janspale/DEXPAND/performance_mapping/Dexpand_Design_study_apw100624.xlsx

Sheet: MM-Elektra assessment
MM Elektra design Study
Medium: | mm
Einheiten: | SI | SI with C
 |  | Power |  | 4 | kW
 |  | Inlet pressure |  | 6.5 | bar | inlet enthalpy | 340.8054099 | kJ/kg
 |  | Inlet Temperature |  | 190 | °C | inlet entropy | 0.787455107 | kj/kg/K
 |  | outlet pressure |  | 0.55 | bar | outlet enthalpy | 289.3110147 | kJ/kg
 |  | enthalpy drop, isentropic |  | 51494.4 | J/kg |  | 3000 | rpm
 |  | spouting velocity |  | 320.9 | m/s
 |  | expansion efficiency |  | 0.4
 |  | massenstrom |  | 0.194 | kg/s
 |  | Power | remark | estimated efficiency | mass flow rate | wheel passes | u_opt | D | h | # nozzles | #flows | mass flow ratio | area ratio
 |  | kW |  |  |  |  | m/s | m | m | -
 | Reference | 4 | experimentally determined | 0.4 | 0.1942 | 4 | 40.11 | 0.2554 | 0.0200 | 2 | 1 | 1.00 | 1.00
 |  | 1 | assessment, smaller than | 0.3 | 0.0647 | 4 | 40.11 | 0.2554 | 0.0130 | 1 | 1 | 0.33 | 0.32
 |  | 2 | experimentally determined | 0.4 | 0.0971 | 4 | 40.11 | 0.2554 | 0.0200 | 1 | 1 | 0.50 | 0.50
 |  | 8 | experimentally determined, better than | 0.4 | 0.3884 | 4 | 40.11 | 0.2554 | 0.0400 | 2 | 1 | 2.00 | 2.00
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
