janspale/DEXPAND/design_tools/RVE_small_Scale.xlsm

Sheet: Hlavní
Nastavení výpočtu (odhad výpočetního času: 24 sekund) |  |  |  | Vstupní parametry cyklu |  |  |  | Zjednodušený model expandér + výparník
Počet kroků | j | - | 1440 | Pracovní látka | PL | - | R1233zdE | Hypotetická průtočná plocha exp | S_exp | mm2 | 12.0
Počet iterací |  | - | 2 | Kritický tlakový poměr | beta_krit | - | 0.61 | Průtok průtočnou plochou S_exp | M_hyp | kg/s | #NAME?
Čas kroku | time | s | 1.375137514e-05 | Tepelný výkon výměníků | Q_vym | kW | 10 | dm = 0, měň S (krok 1) | dif_m1 | mg/s
Hlavní parametry - stroj |  |  |  | Podíl oleje | podil_olej | - | 0.05 | dm = 0, měň t_ad (krok 2) | dif_m2 | mg/s | #NAME?
Průměr statoru | D | #VALUE! | 64.0 | Tepelná kapacita oleje | cp_olej | kJ/kg | 2.2 | reziduum tepelného výkonu | q_rez | kW | 3.745
Průměr rotoru | d | #VALUE! | 55.0 | Admisní teplota | t_ad | °C | 105.0 | Výstupní parametry - geometrie
Radiální vůle | vr | mm | 0.1 | Admisní přehřátí | dT_ad | K | 5 | Vstupní objem | V_init | mm3 | 2698.901387
Excentricita, Dop.: (3.5 až 4.5) | e | mm | 4.4 | Admisní tlak | p_ad | kPa | 1042.3 | Výstupní objem | V_out | mm3 | 6819.902706
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
