janspale/DEXPAND/design_tools/orc_axial/orcturbax_v8_r10.xlsm

Sheet: main
 |  |  |  |  |  |  | 122.0987534 |  |  |  |  |  |  |  | 432.159
 |  | MIDSPAN |  |  |  | 122.0987534 |  | 11.81818182 |  |  |  | 432.009
MM |  | Thermodynamic BCs |  |  | Turbomachine BCs |  |  | Calculation of output parameters |  |  | Critical temperature iteration |  |  | Calculation of the nozzle |  |  | Additional losses |  |  |  |  |  | 8.314446 |  |  |  |  |  |  | h_nozz | 11 | mm
tp |  | p_1 | 0.65 | Mpa | n | 16000 | rpm | a_2_is | 147.067371 | m/s | T*_id | 171.5243379 | °C | T_2 | 159.009 | °C | P_loss_dfr | 36.50324376 | W |  | 0.08461538462 |  | 162.38 |  |  | 12.751 |  |  |  |  | alpha_2 | eta_is | h_out/h_in
ph | 463.15 | T_1 | 190 | °C | D | 0.15 | m | Ma_2_is | 2.1821201 | - | T*_it | 181.4743379 | °C | T_2_is | 153.657 | °C | P_loss_venti | 912.9356393 | W |  |  |  | 0.05120363345 |  |  | 1.2 |  |  | 2.37354531 |  | 7 | 0.7081 | 1.28
ps |  | p_3 | 0.055 | MPa | alpha_2 | 14 | ° | phi_2 | 0.8986596721 |  | a*_it | 134.2638479 | m/s | p_2 | 0.055 | Mpa | P_turb | 9765.45 | W |  |  |  | 51.20363345 |  |  | 15.3012 |  |  |  |  | 8 | 0.6979 | 1.266
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
