janspale/DEXPAND/experimental_data/air_PDLT/RVE_air_PDLT_steady_states_designconditions.csv

pin | rotation speed | torque | Power | volumetric flow rate (DN 40) | p1 | p2 | p3 | p4 | p5 | p6 | room temp
bara | U/min | Nm | W | Nmｳ/h | bar | bar | bar | bar | bar | bar | ｰC
9.02 | 3280.858464 | -3.282088 | -1058.889499 | 48.872802 | 0.980102 | 0.977905 | 0.974324 | 0.979586 | 0.97899 | 0.979739 | 21.749303
9.02 | 3280.807994 | -3.279765 | -1058.12318 | 48.884788 | 0.980092 | 0.977902 | 0.974335 | 0.97958 | 0.978986 | 0.979739 | 21.749361
9.02 | 3278.78923 | -3.186844 | -1027.470422 | 49.364238 | 0.979665 | 0.977788 | 0.974799 | 0.979348 | 0.978831 | 0.979749 | 21.751672
9.02 | 3278.76039 | -3.187324 | -1027.615728 | 49.337389 | 0.97968 | 0.9778 | 0.974792 | 0.979355 | 0.978839 | 0.979751 | 21.750482
9.02 | 3278.19802 | -3.196697 | -1030.449188 | 48.813829 | 0.979981 | 0.978026 | 0.974659 | 0.979497 | 0.978999 | 0.979804 | 21.727273
9.02 | 3278.390283 | -3.19926 | -1031.340372 | 48.813829 | 0.979996 | 0.978009 | 0.974688 | 0.979498 | 0.978978 | 0.979816 | 21.731109
9.02 | 3280.168719 | -3.222971 | -1039.583829 | 48.813829 | 0.98013 | 0.977858 | 0.974957 | 0.979511 | 0.978785 | 0.979921 | 21.766595
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
