janspale/DEXPAND/design_tools/orc_axial/expansion_line_h_s.png

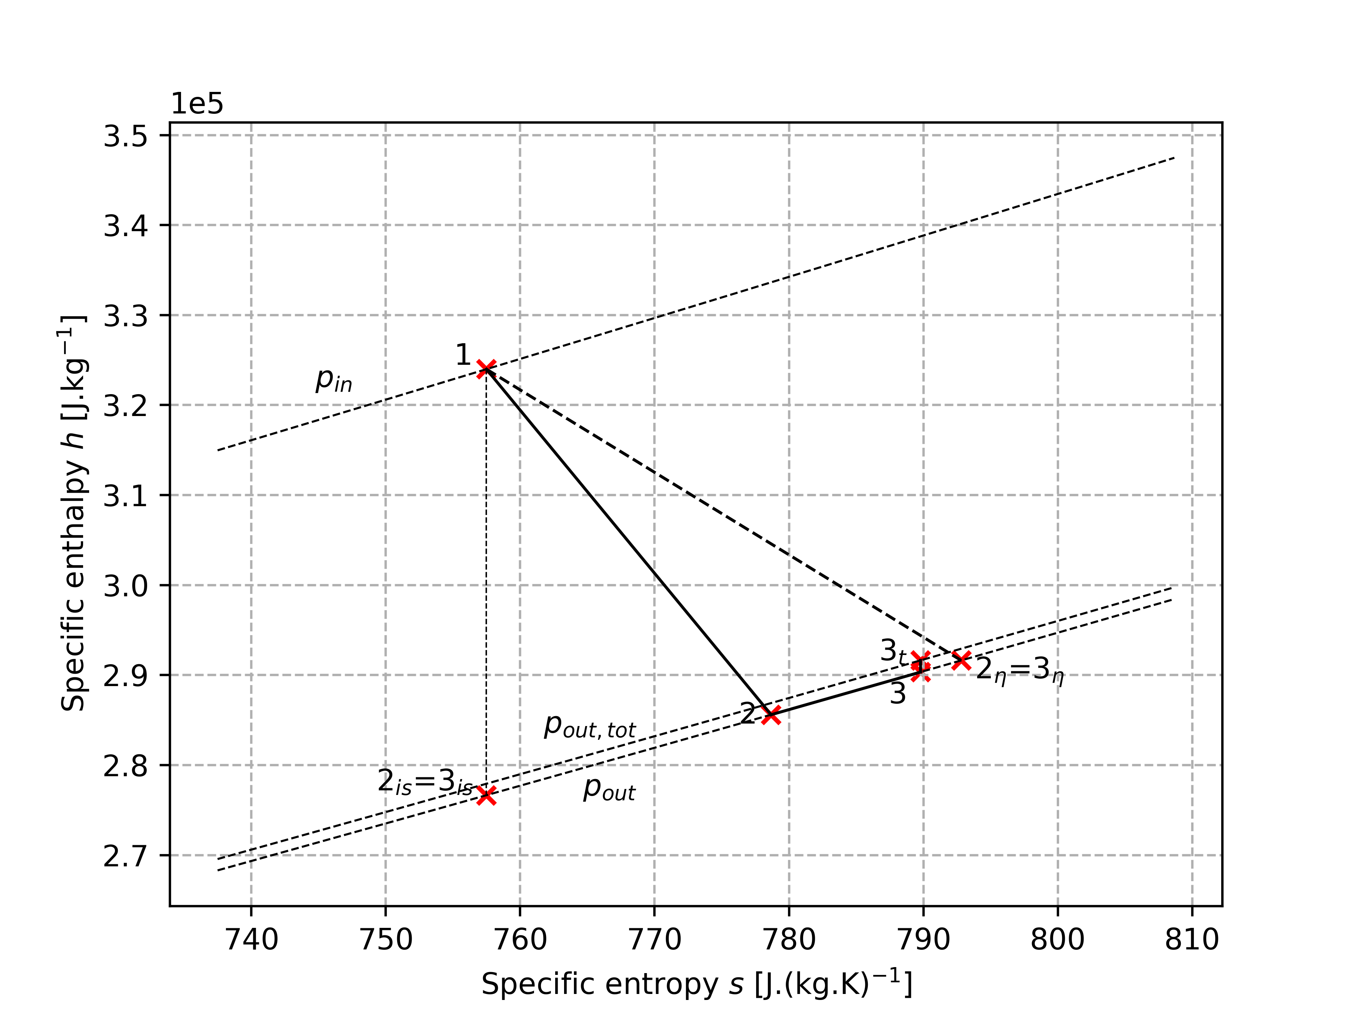
design_tools/orc_axial/expansion_line_h_s.png
