janspale/DEXPAND/design_tools/orc_axial/Gamma_P_v_diagram.png

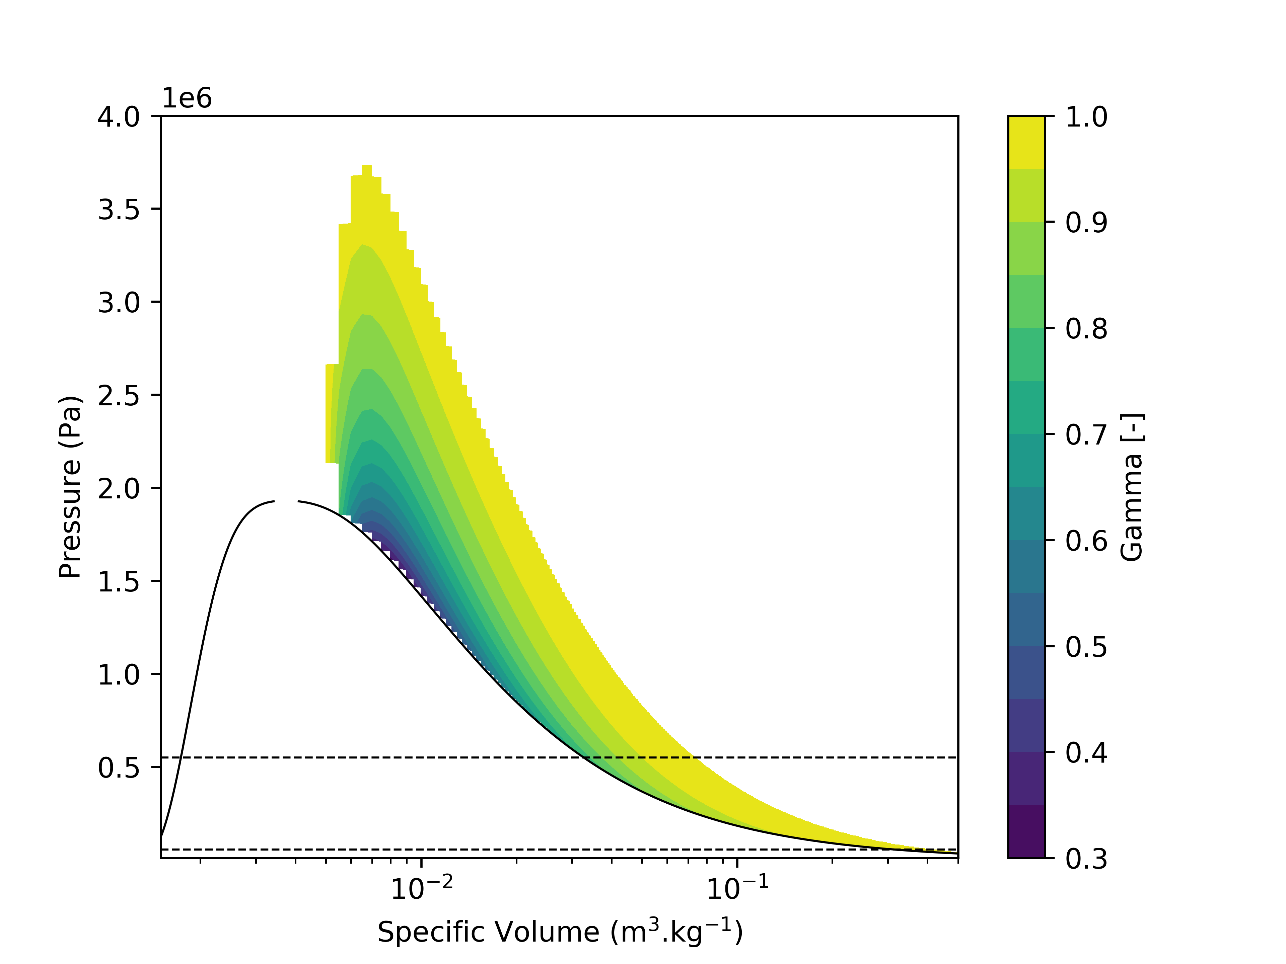
design_tools/orc_axial/Gamma_P_v_diagram.png
