janspale/DEXPAND/design_tools/orc_axial/Gamma_T_s_diagram.png

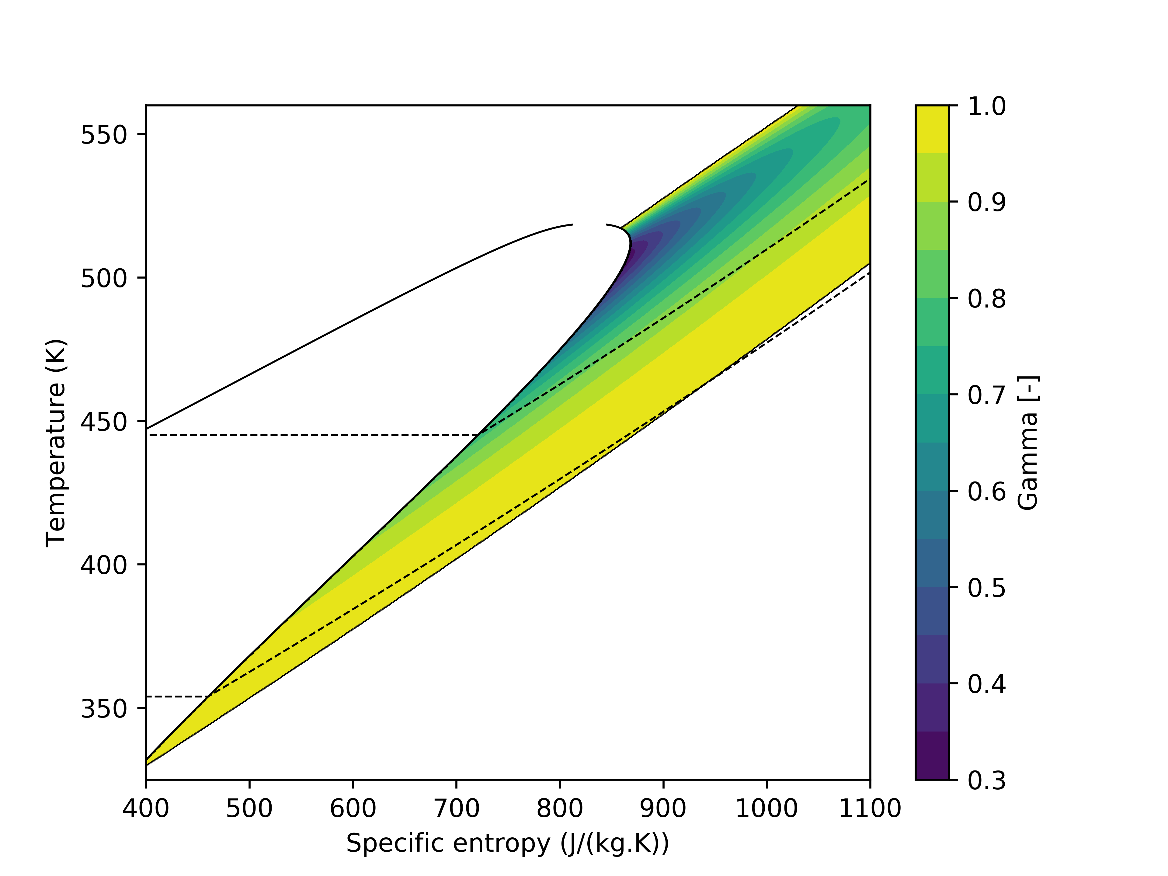
design_tools/orc_axial/Gamma_T_s_diagram.png
