janspale/DEXPAND/design_tools/orc_axial/isentropic_expansion_nozzle_losses.png

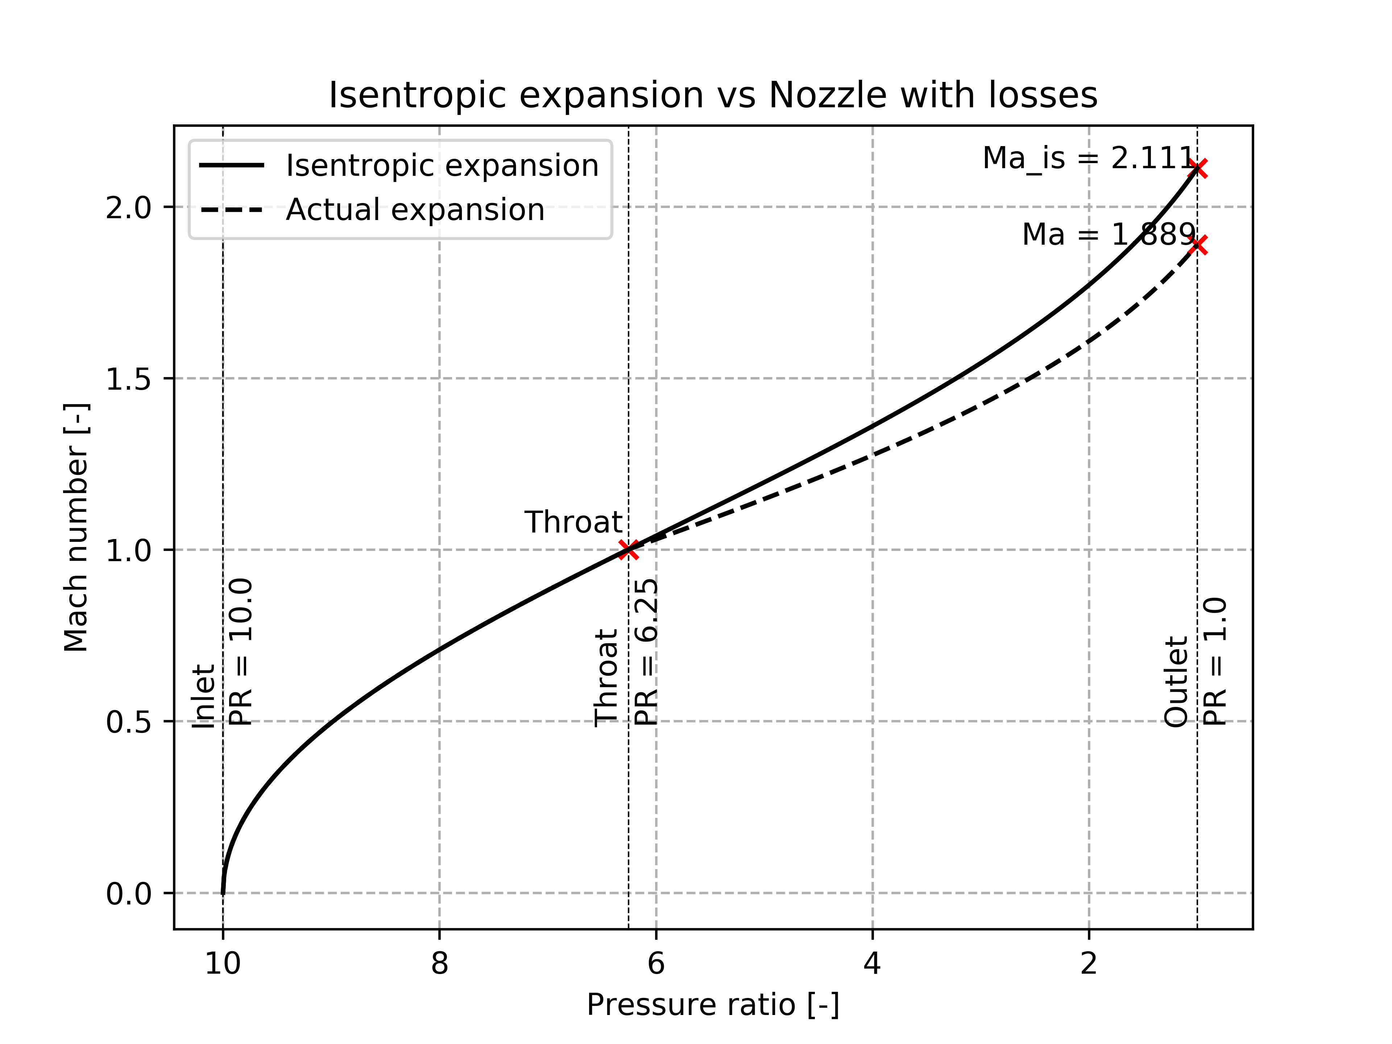
design_tools/orc_axial/isentropic_expansion_nozzle_losses.png
