janspale/DEXPAND/design_tools/orc_axial/velocity_triangles.png

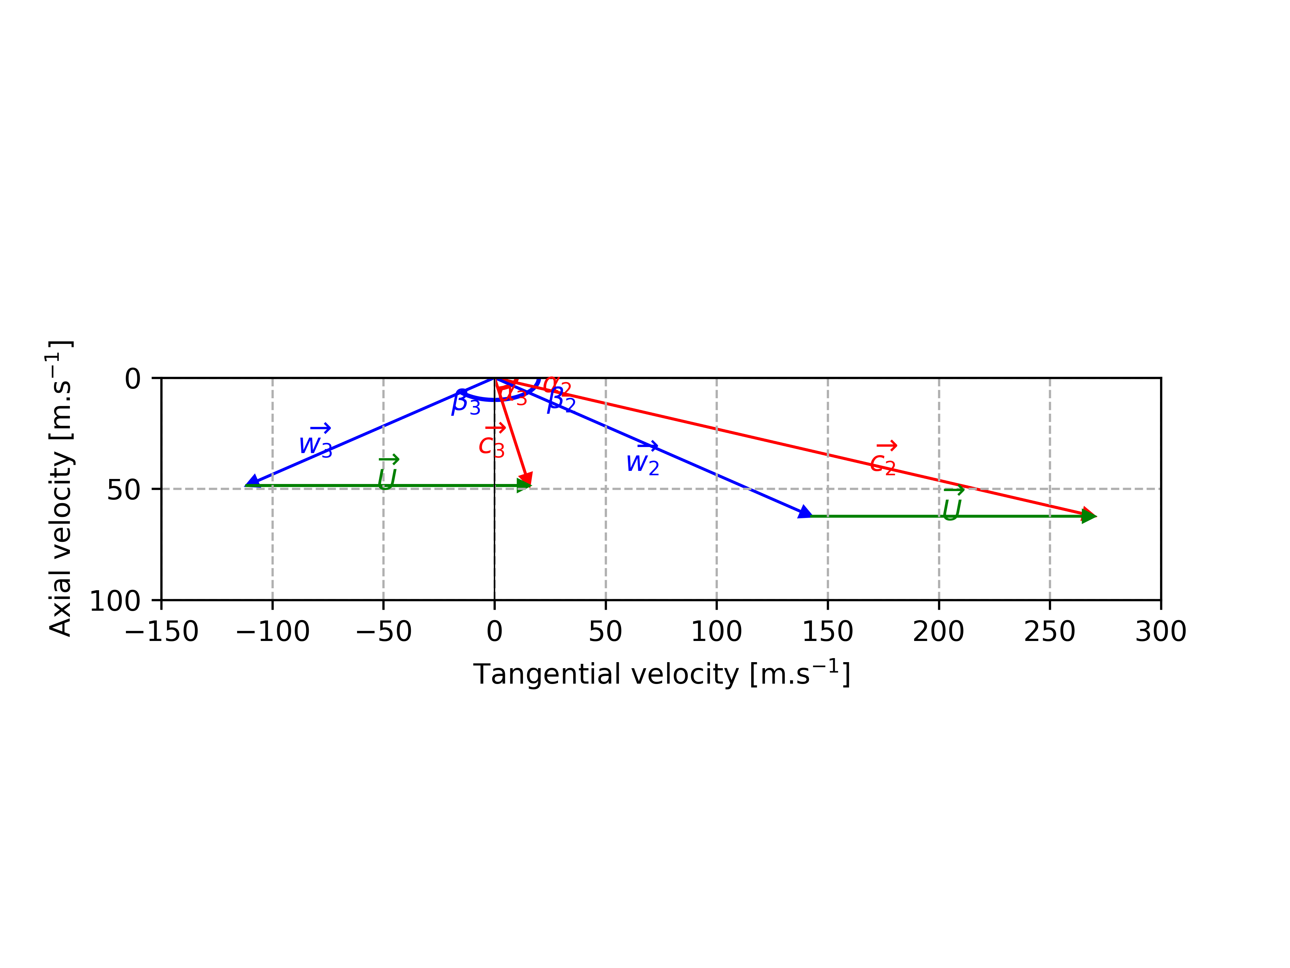
design_tools/orc_axial/velocity_triangles.png
