janspale/DEXPAND/geometries/air_RVE/air_rve.png

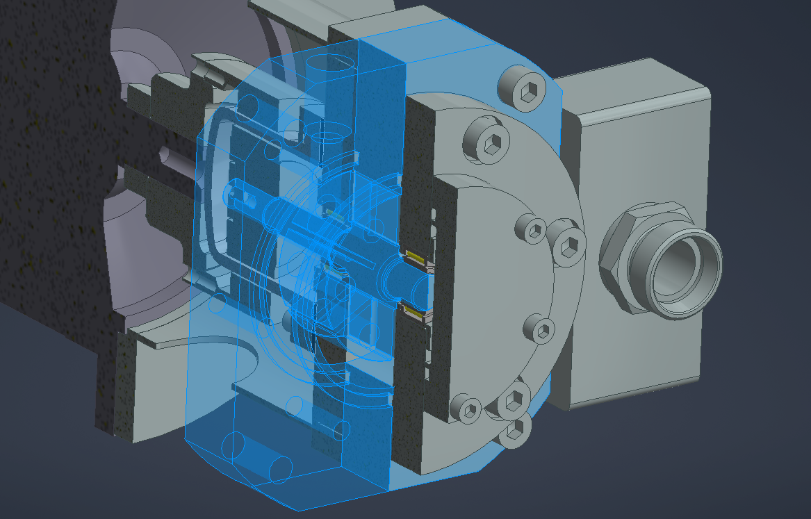
geometries/air_RVE/air_rve.png
