janspale/DEXPAND/isentropic_expansion_nozzle_losses.png

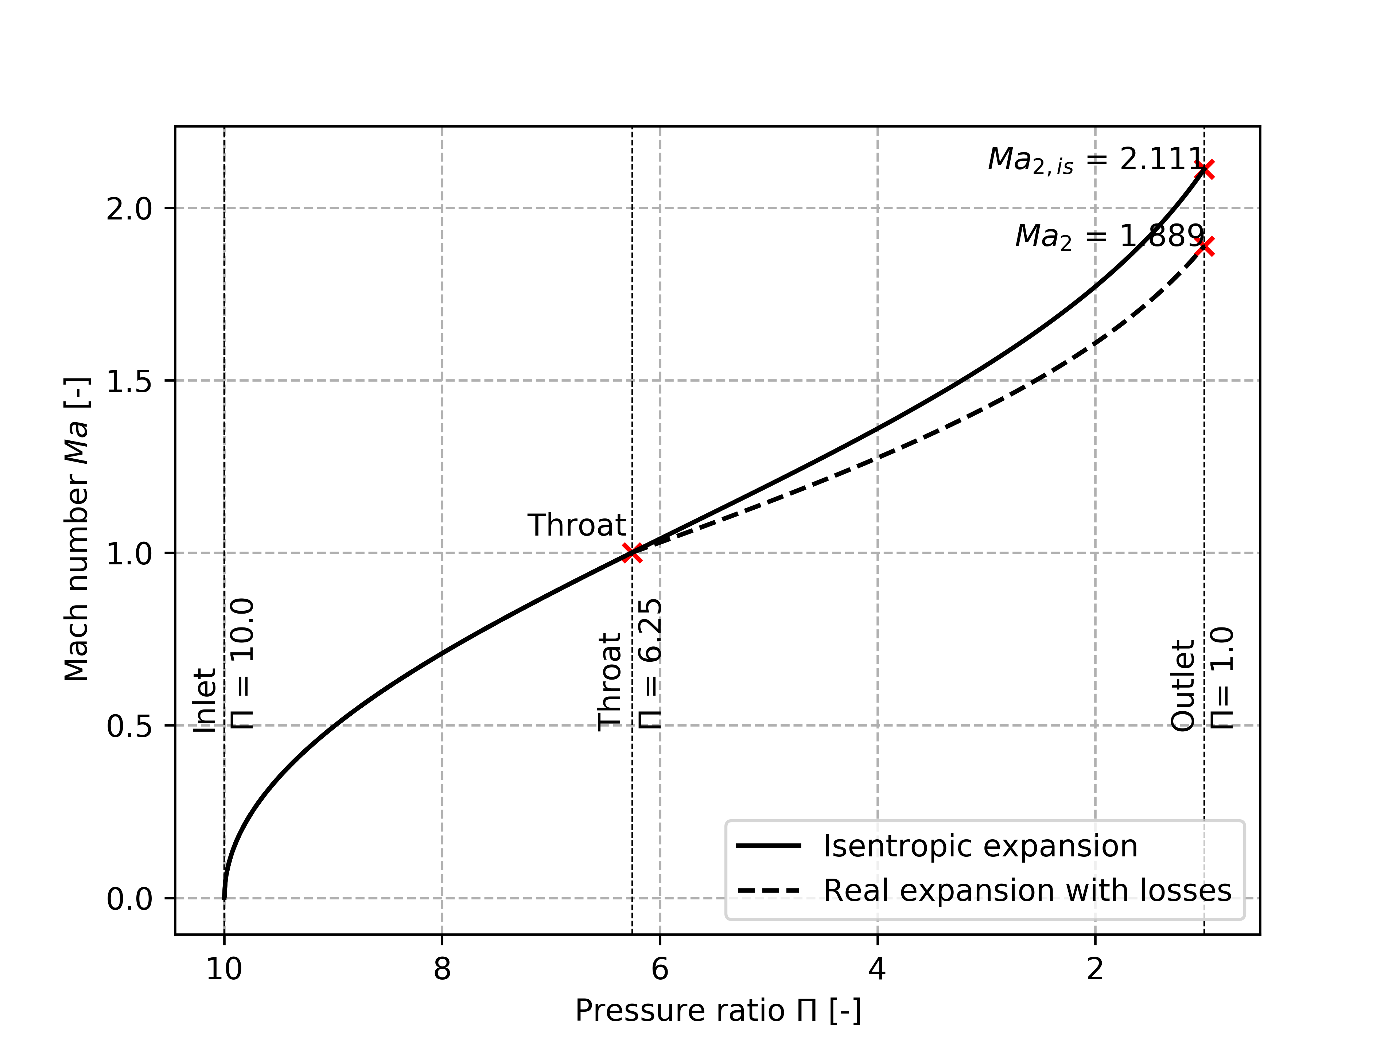
isentropic_expansion_nozzle_losses.png
