janspale/DEXPAND/pareto_frontier_eta_rpm.png

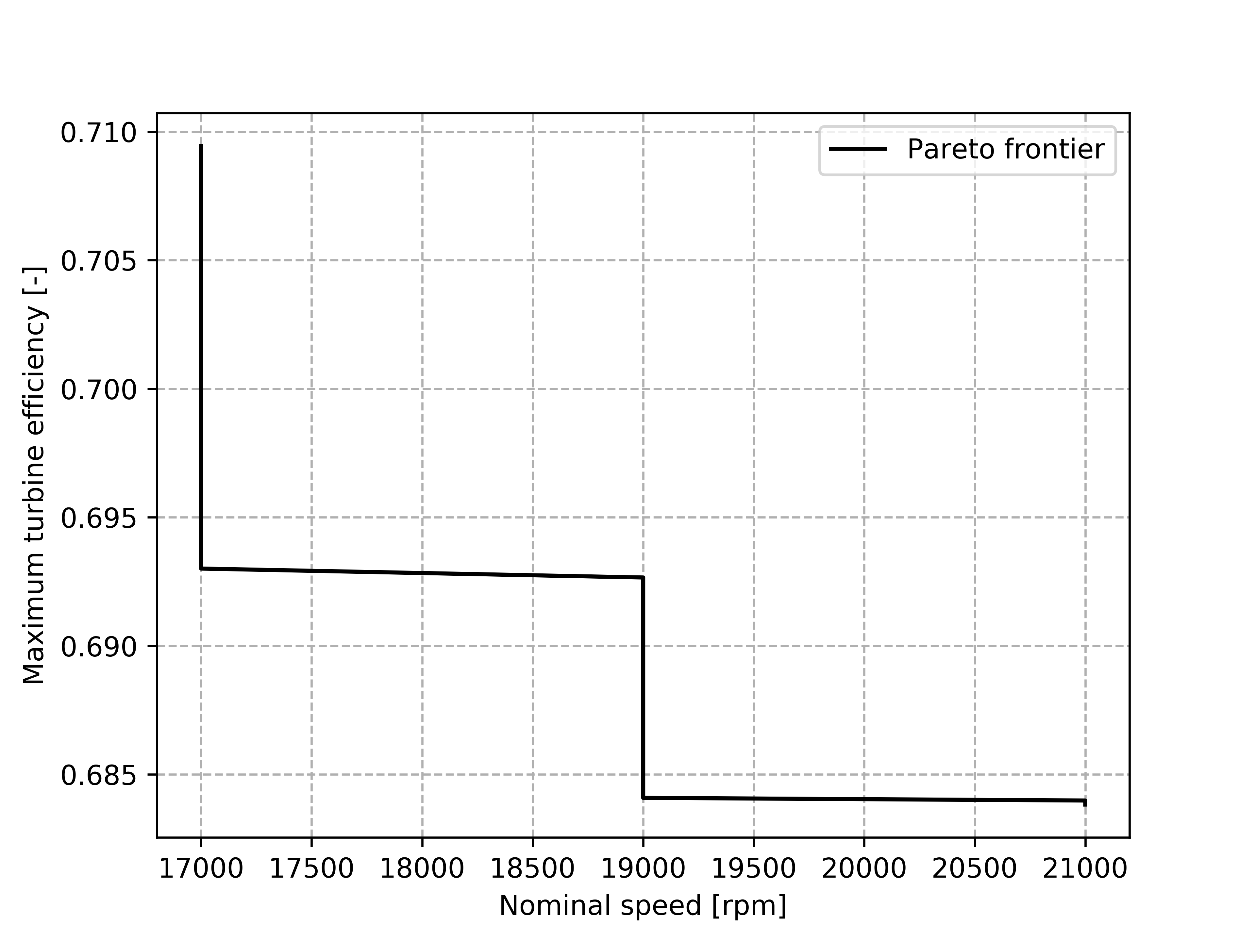
pareto_frontier_eta_rpm.png
