janspale/DEXPAND/sensitivity_analysis_p_inlet.png

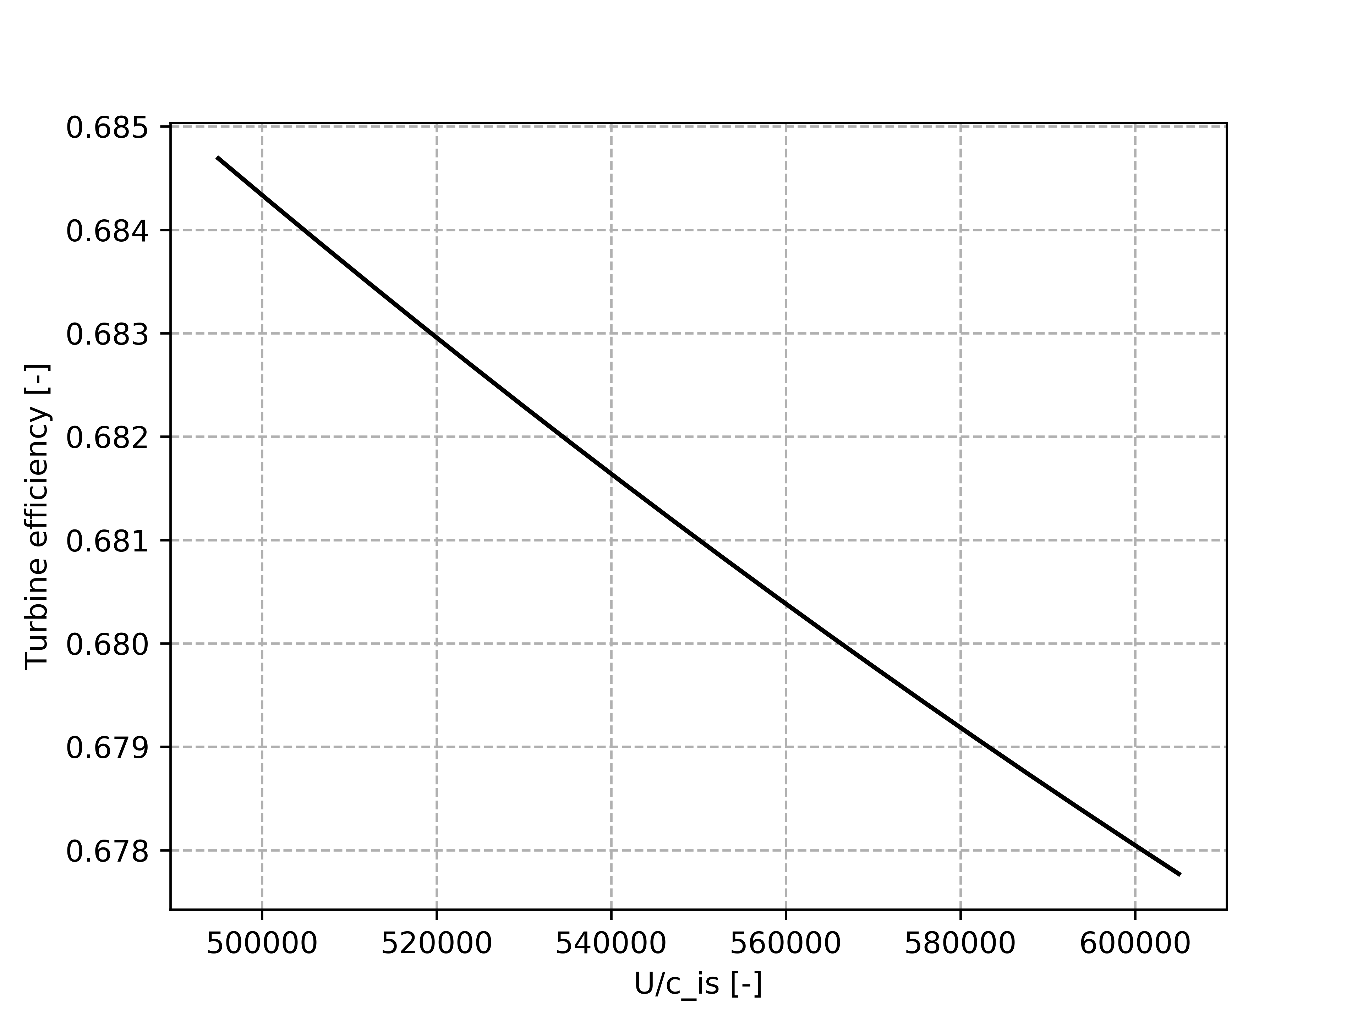
sensitivity_analysis_p_inlet.png
