janspale/DEXPAND/sensitivity_analysis_rpm.png

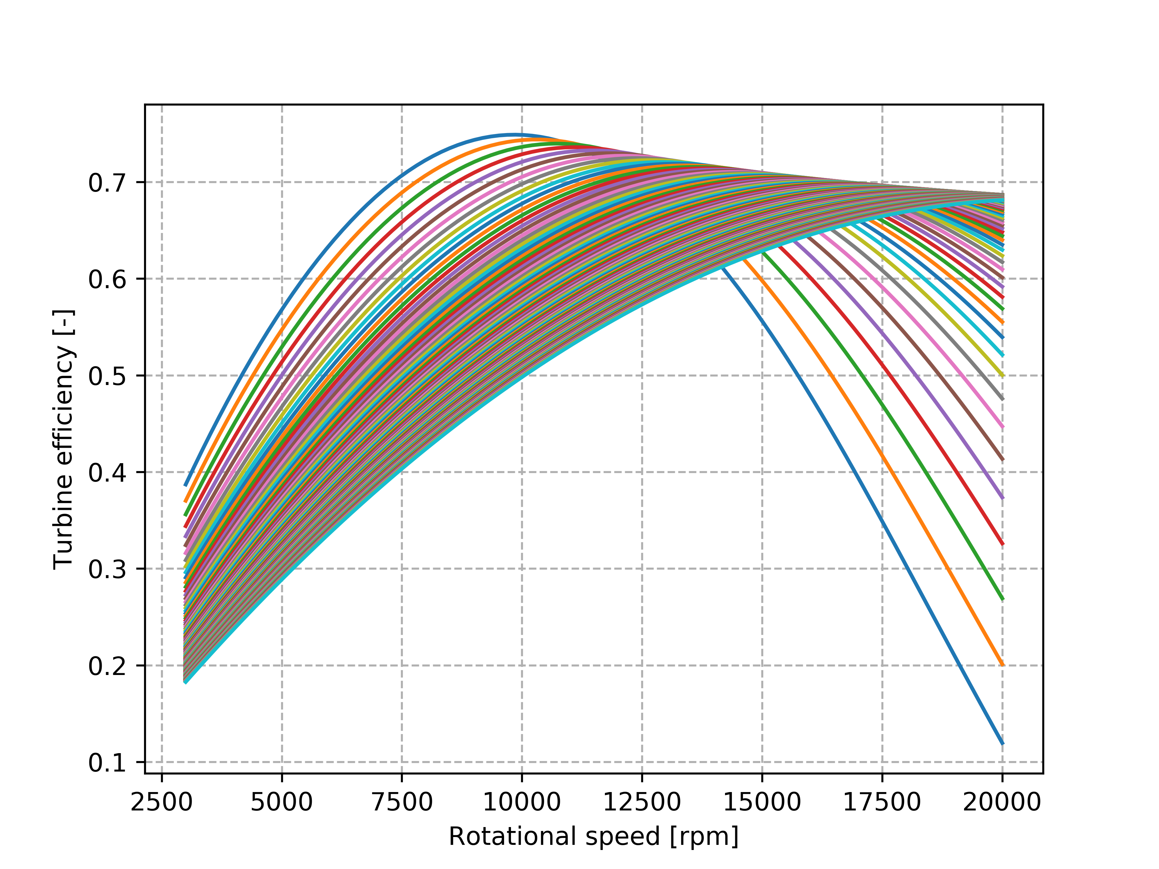
sensitivity_analysis_rpm.png
