janspale/DEXPAND/sensitivity_analysis_rpm_efficiency_heatmap.png

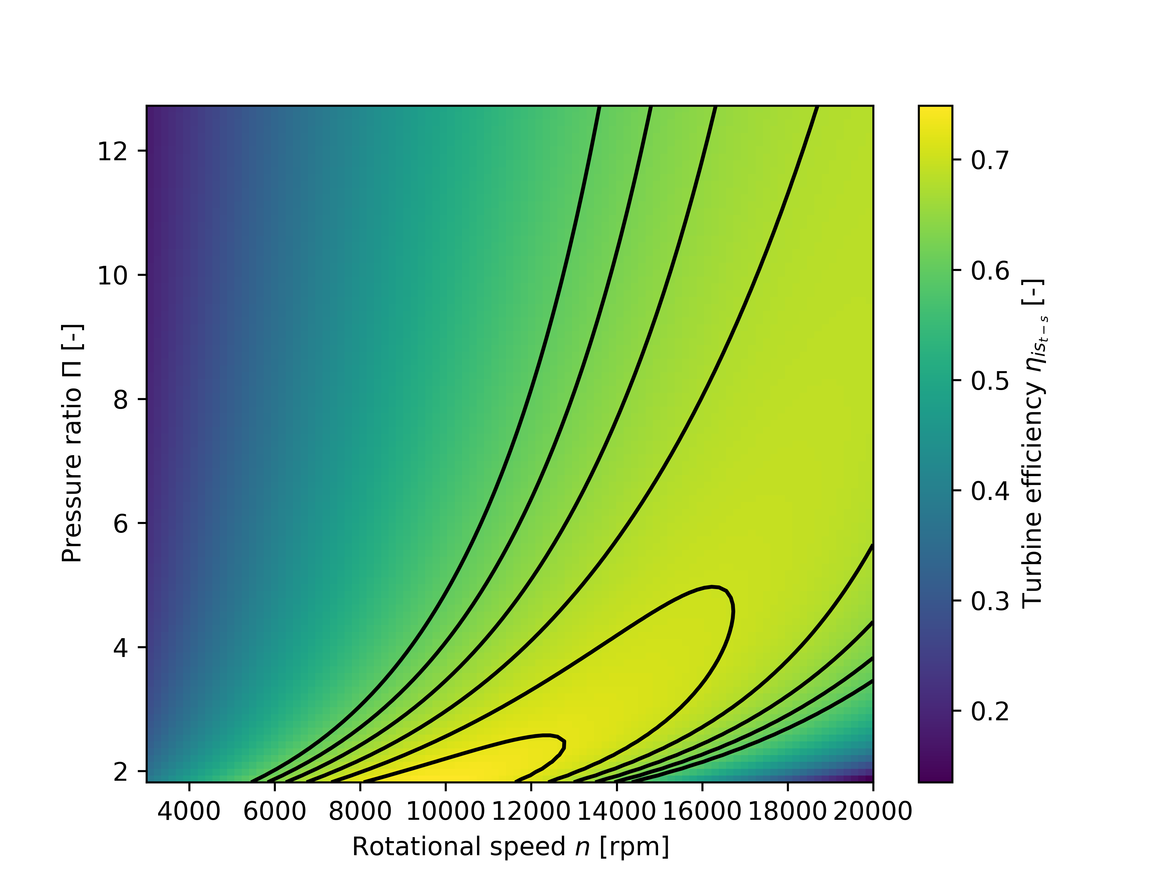
sensitivity_analysis_rpm_efficiency_heatmap.png
