janspale/DEXPAND/sensitivity_analysis_rpm_power.png

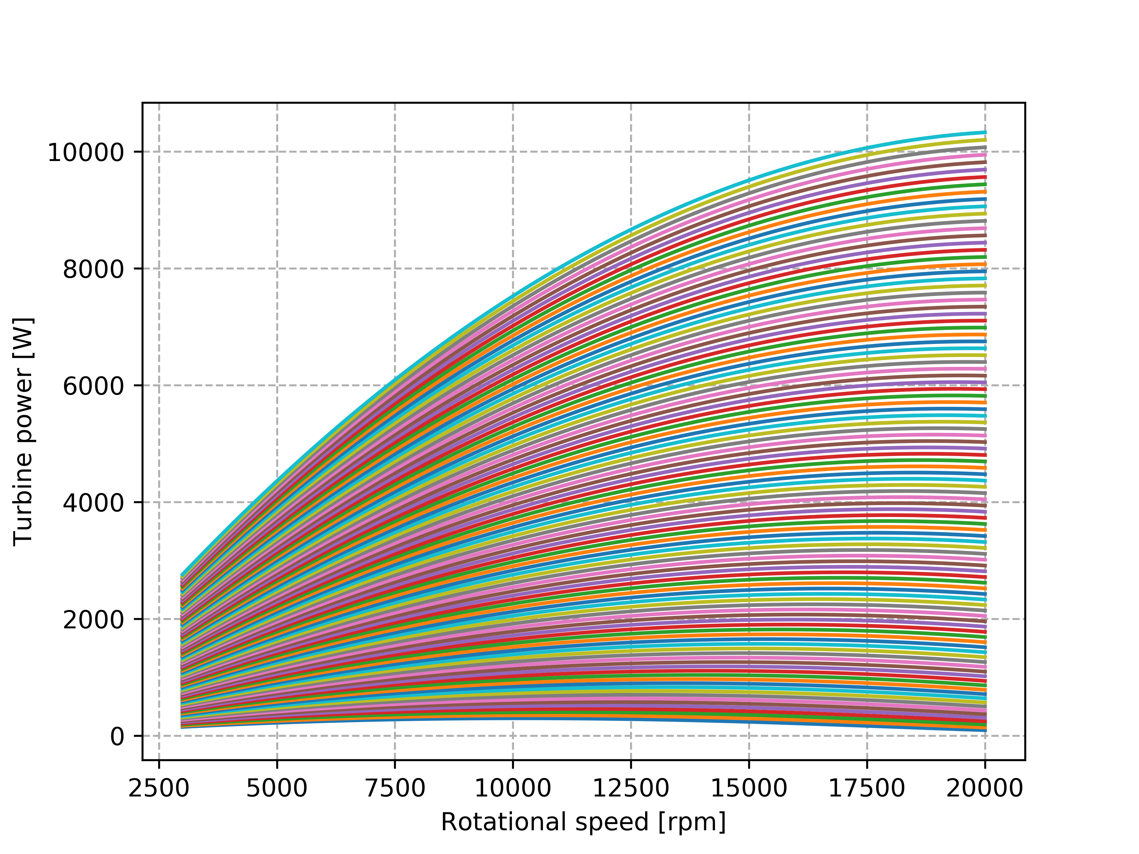
sensitivity_analysis_rpm_power.png
