janspale/DEXPAND/sensitivity_analysis_rpm_power_heatmap.png

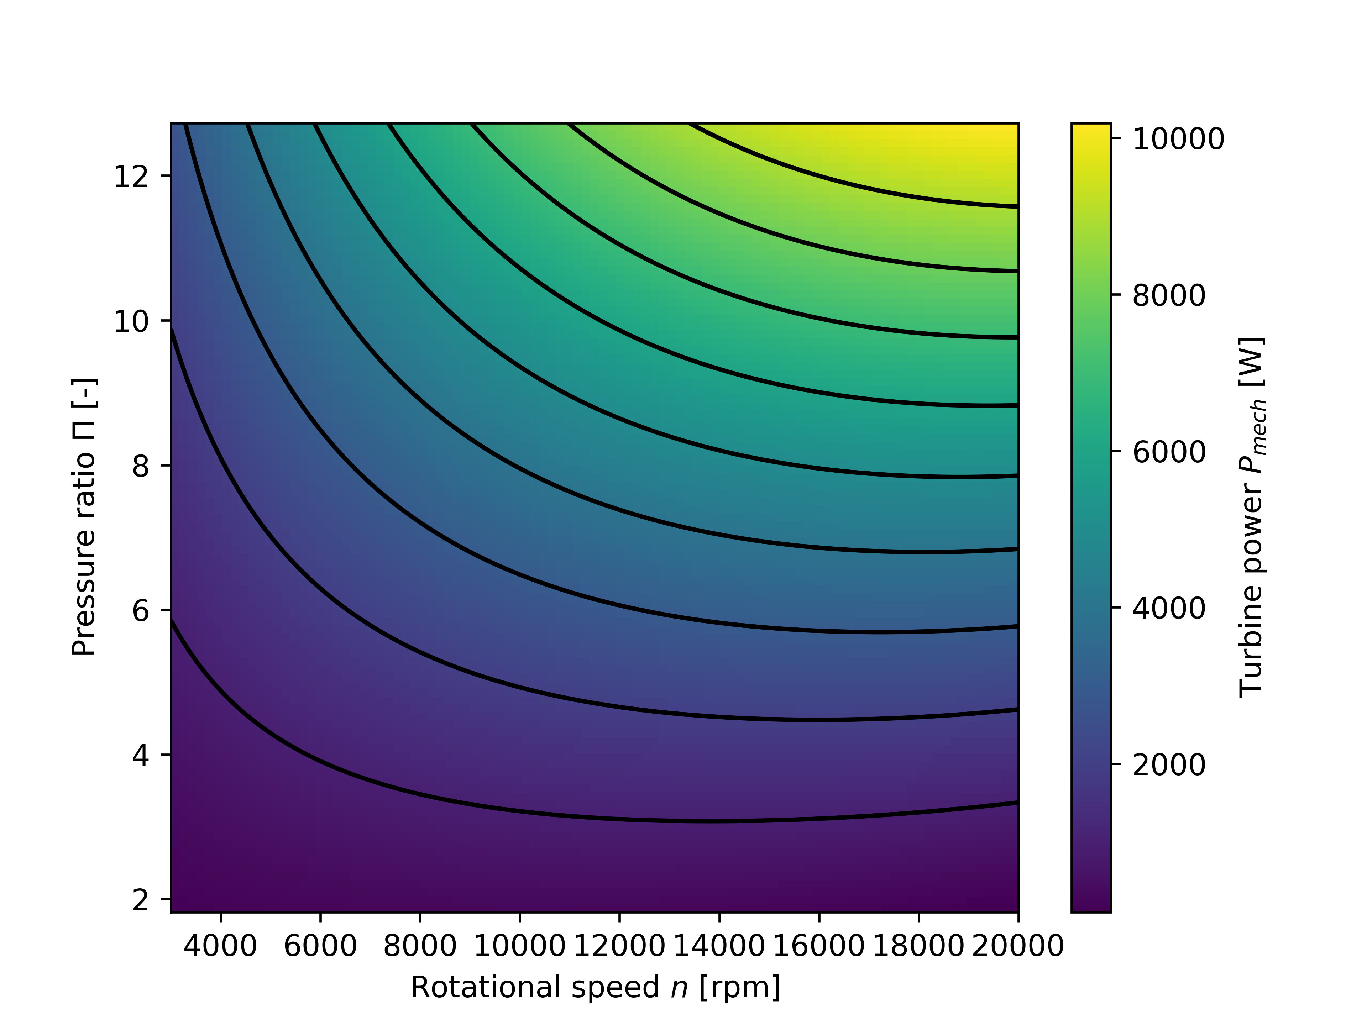
sensitivity_analysis_rpm_power_heatmap.png
