janspale/DEXPAND/sensitivity_analysis_rpm_power_max.png

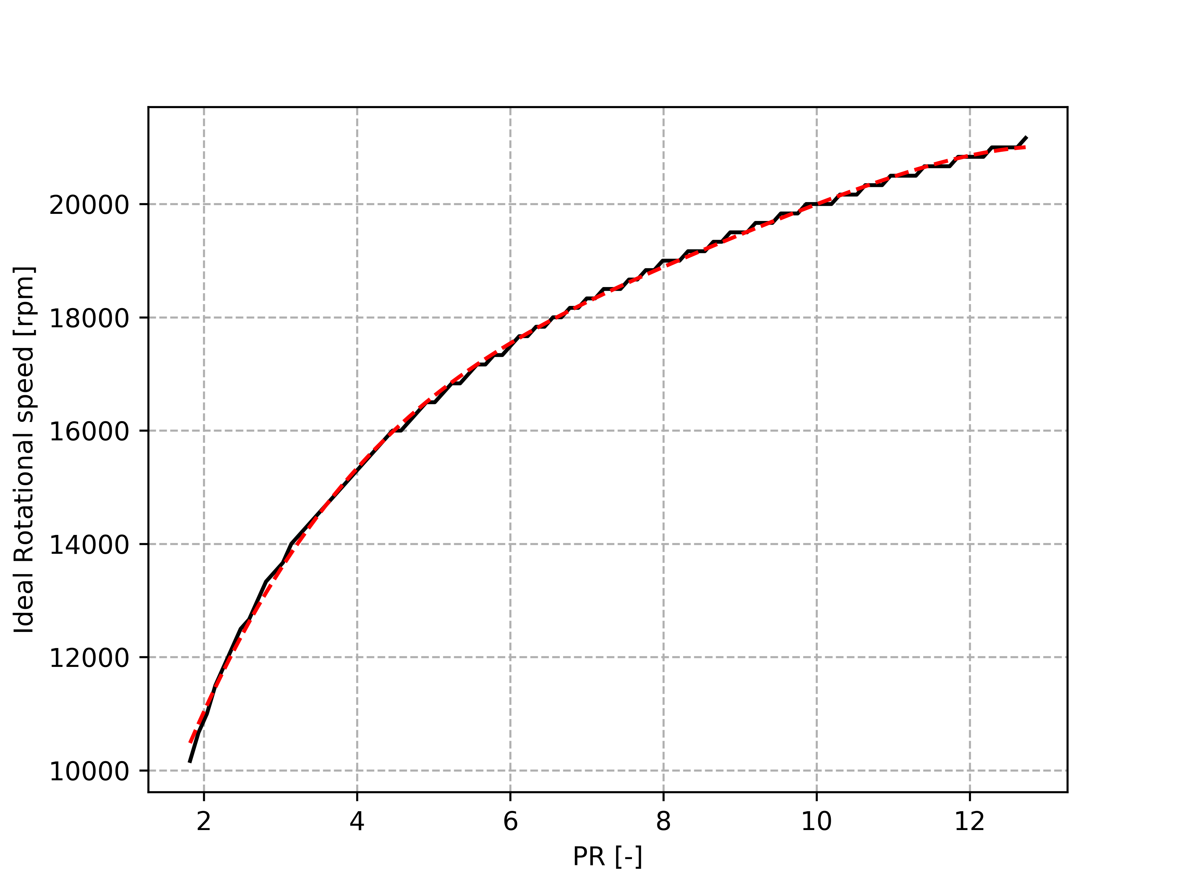
sensitivity_analysis_rpm_power_max.png
