janspale/DEXPAND/sensitivity_analysis_rpm_torque_heatmap.png

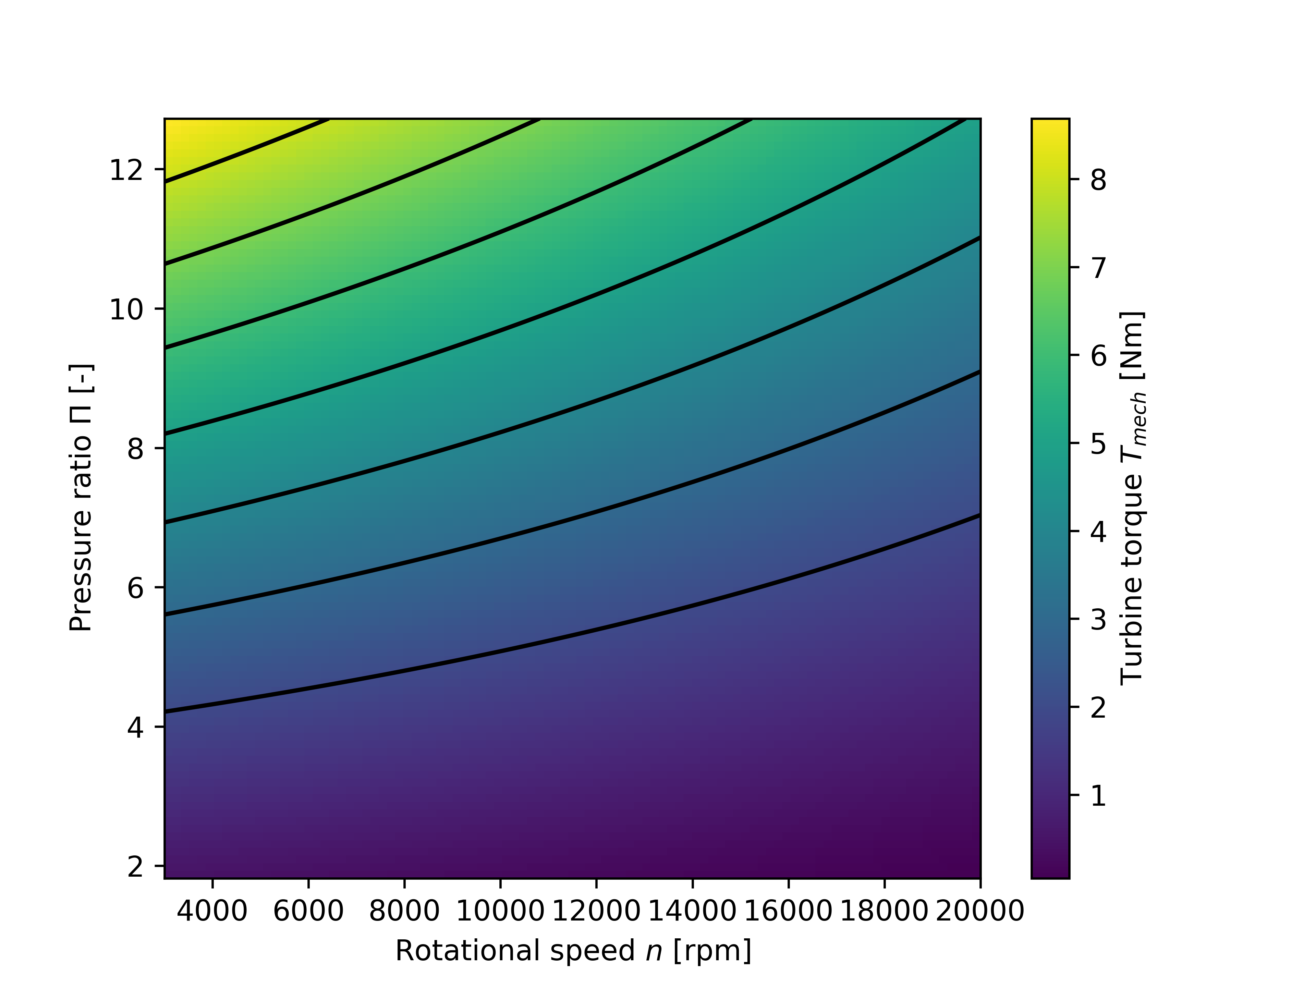
sensitivity_analysis_rpm_torque_heatmap.png
