janspale/DEXPAND/geometries/air_RVE/parts/LE-CB-010-01 Příruba generátoru.stp

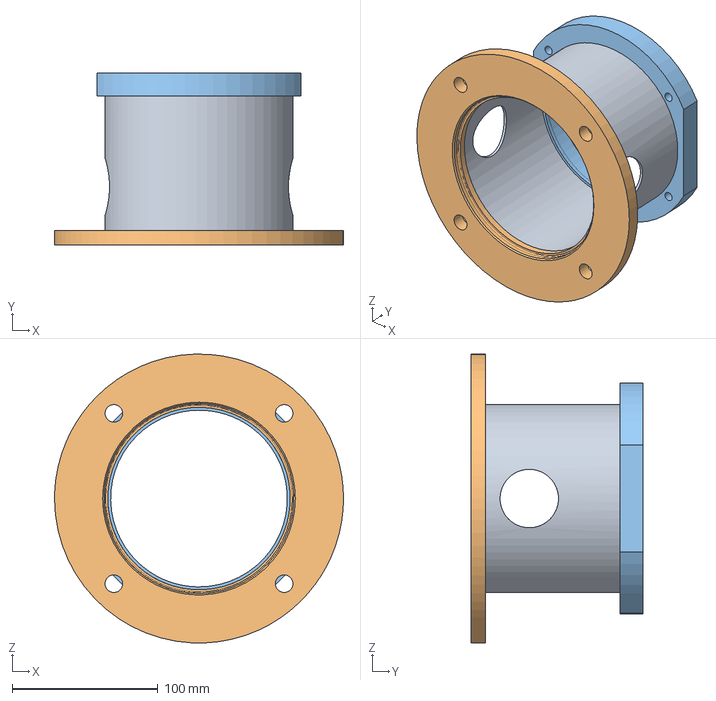
[picture p73: CAD file, 2024-02-19]
geometries/air_RVE/parts/LE-CB-010-01 Příruba generátoru.stp
198.0 x 118.0 x 197.9 mm
