janspale/DEXPAND/geometries/MM_turbine/AxT2-R-02 RotorBuckets_v2.stl

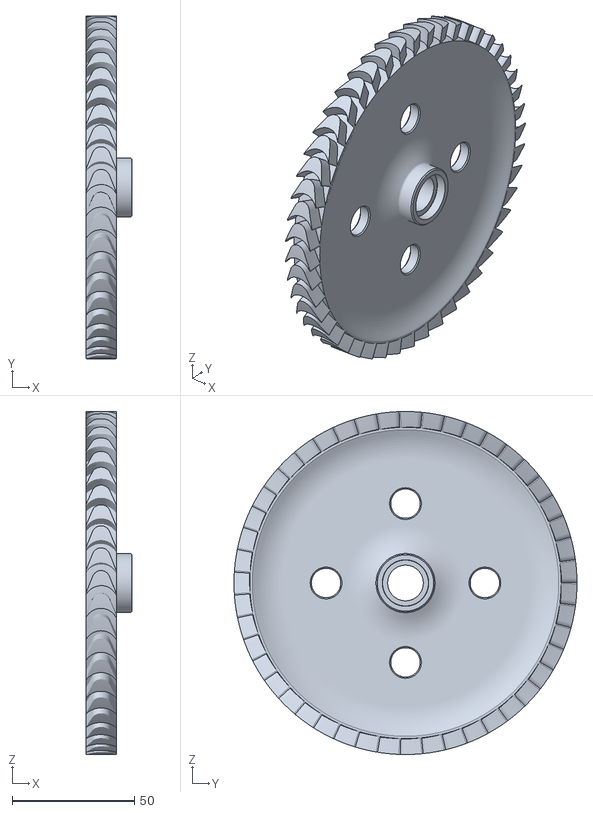
[picture p74: CAD file, 2024-02-19]
geometries/MM_turbine/AxT2-R-02 RotorBuckets_v2.stl
19.0 x 140.4 x 140.4
