janspale/DEXPAND/geometries/air_RVE/parts/LE-CB-002-01 Rotor.stp

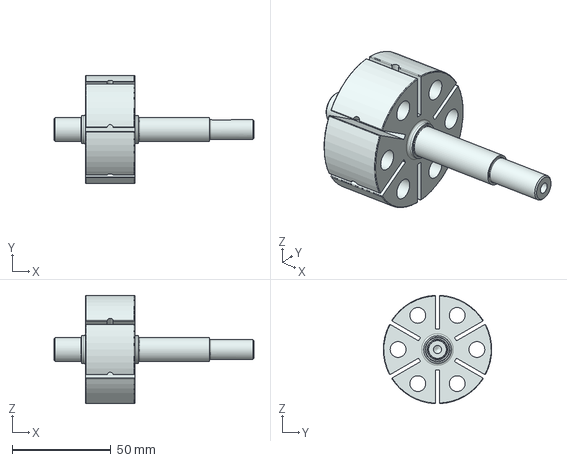
[picture p75: CAD file, 2024-02-19]
geometries/air_RVE/parts/LE-CB-002-01 Rotor.stp
101.5 x 55.0 x 54.9 mm
