janspale/DEXPAND/geometries/MM_turbine/AxT2-S-02 StatorNozzles_v2.stl

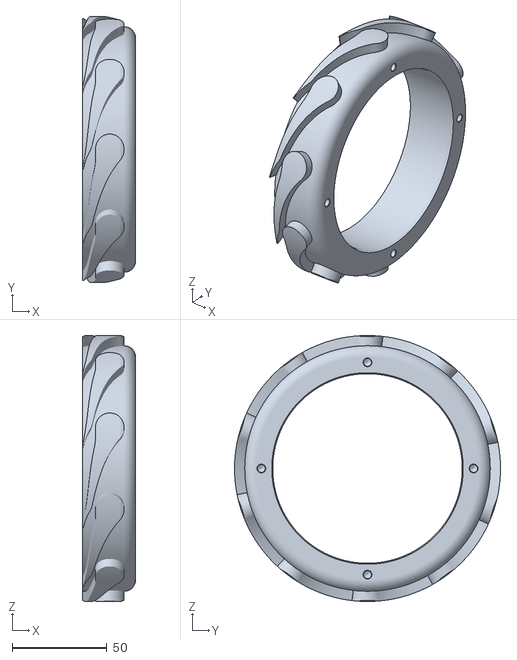
[picture p76: CAD file, 2024-02-19]
geometries/MM_turbine/AxT2-S-02 StatorNozzles_v2.stl
28.0 x 140.4 x 140.4
