janspale/DEXPAND/geometries/air_RVE/parts/LE-CB-007-01 Lamela.stp

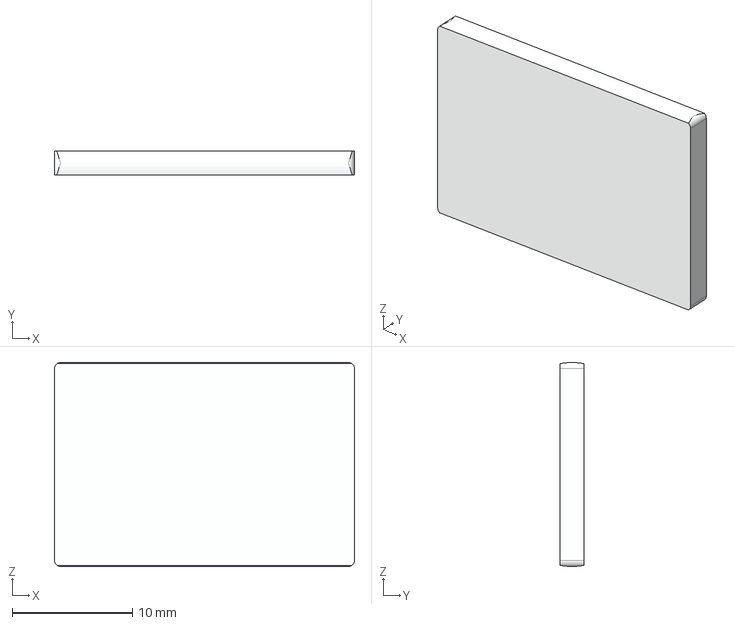
[picture p77: CAD file, 2024-02-19]
geometries/air_RVE/parts/LE-CB-007-01 Lamela.stp
25.0 x 2.00 x 17.0 mm
