janspale/DEXPAND/geometries/air_RVE/parts/LE-CB-001-01 Stator.stp

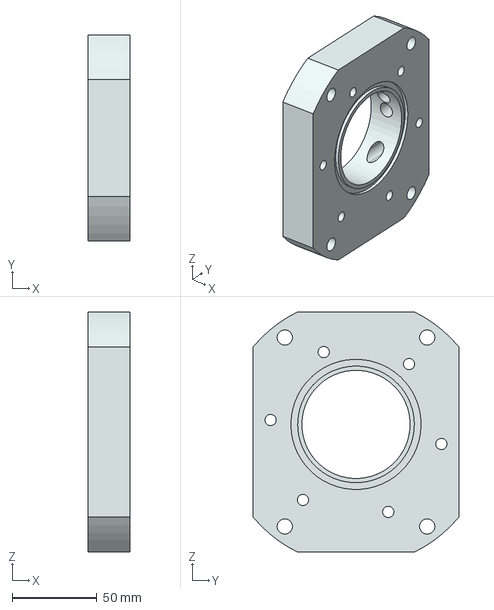
[picture p78: CAD file, 2024-02-19]
geometries/air_RVE/parts/LE-CB-001-01 Stator.stp
25.0 x 122.0 x 142.0 mm
