janspale/DEXPAND/geometries/air_RVE/parts/LE-CB-011-01 Kroužek distanční.stp

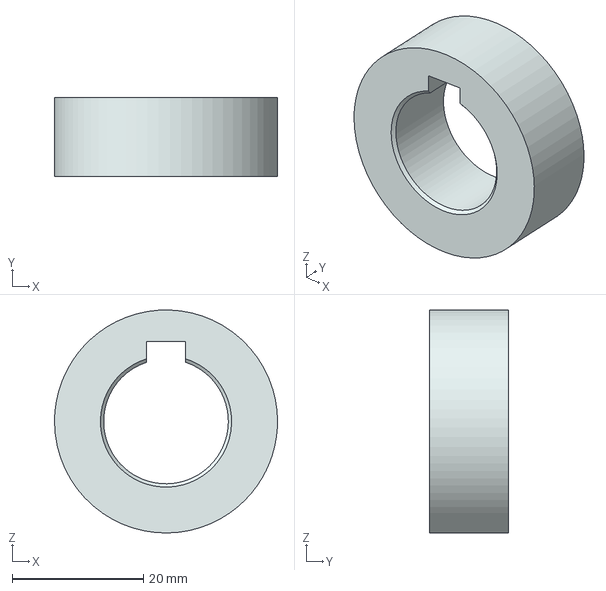
[picture p79: CAD file, 2024-02-19]
geometries/air_RVE/parts/LE-CB-011-01 Kroužek distanční.stp
34.0 x 12.0 x 34.0 mm
