janspale/DEXPAND/geometries/air_RVE/parts/LE-CB-006-01 Kroužek zajišťovací.stp

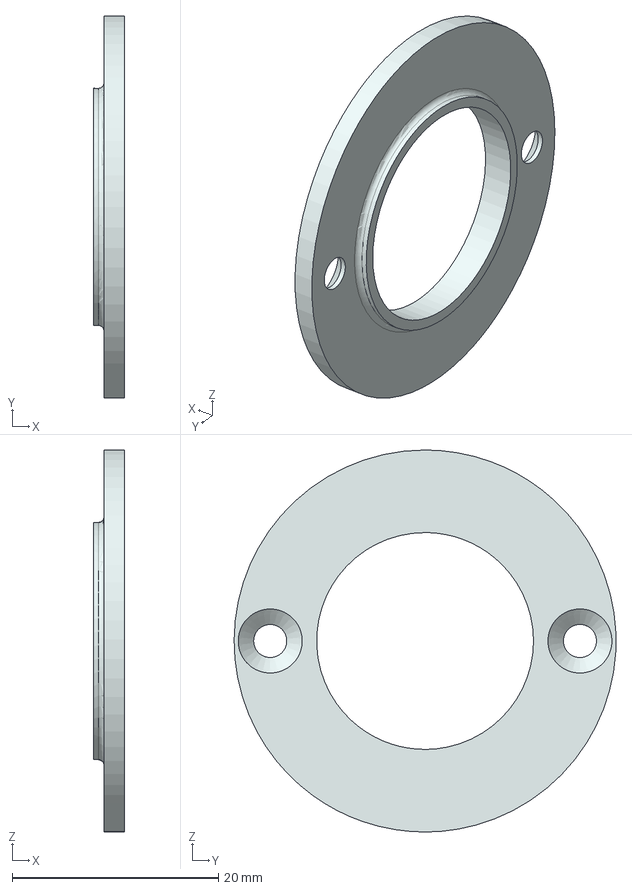
[picture p80: CAD file, 2024-02-19]
geometries/air_RVE/parts/LE-CB-006-01 Kroužek zajišťovací.stp
3.00 x 37.0 x 37.0 mm
