janspale/DEXPAND/geometries/air_RVE/parts/LE-CB-005-01 Sběrnice emisní.stp

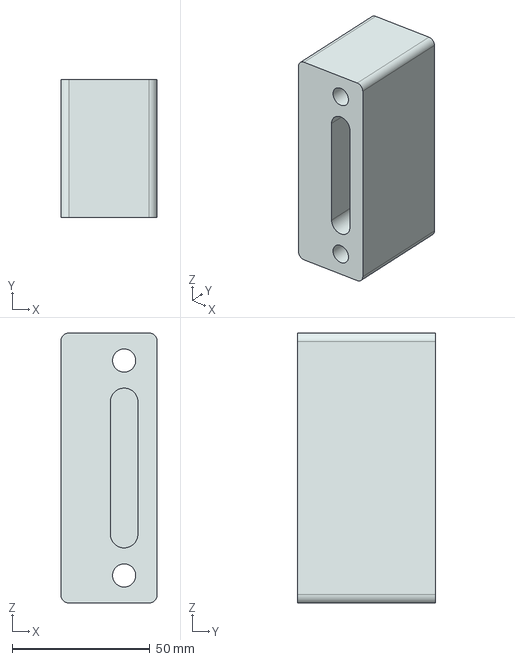
[picture p81: CAD file, 2024-02-19]
geometries/air_RVE/parts/LE-CB-005-01 Sběrnice emisní.stp
35.0 x 50.0 x 98.0 mm
