janspale/DEXPAND/geometries/air_RVE/parts/LE-CB-009-01 Podložka.stp

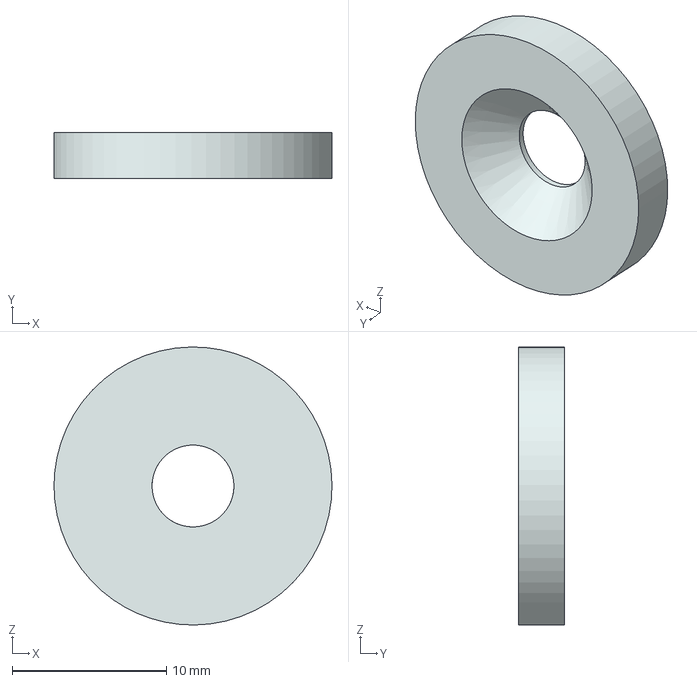
[picture p82: CAD file, 2024-02-19]
geometries/air_RVE/parts/LE-CB-009-01 Podložka.stp
18.0 x 3.00 x 18.0 mm
