janspale/DEXPAND/geometries/air_RVE/parts/LE-CB-003-01 Čelo.stp

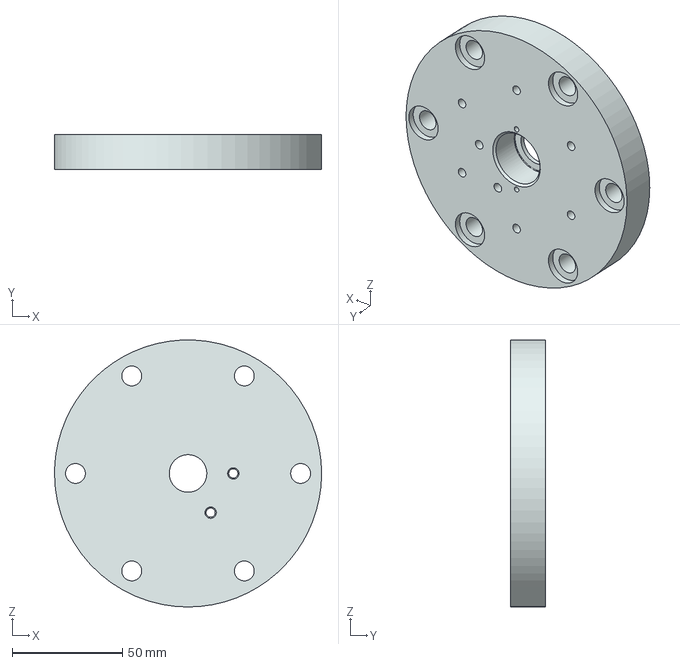
[picture p83: CAD file, 2024-02-19]
geometries/air_RVE/parts/LE-CB-003-01 Čelo.stp
121.0 x 16.0 x 120.9 mm
