janspale/DEXPAND/geometries/air_RVE/parts/LE-CB-008-01 Kryt.stp

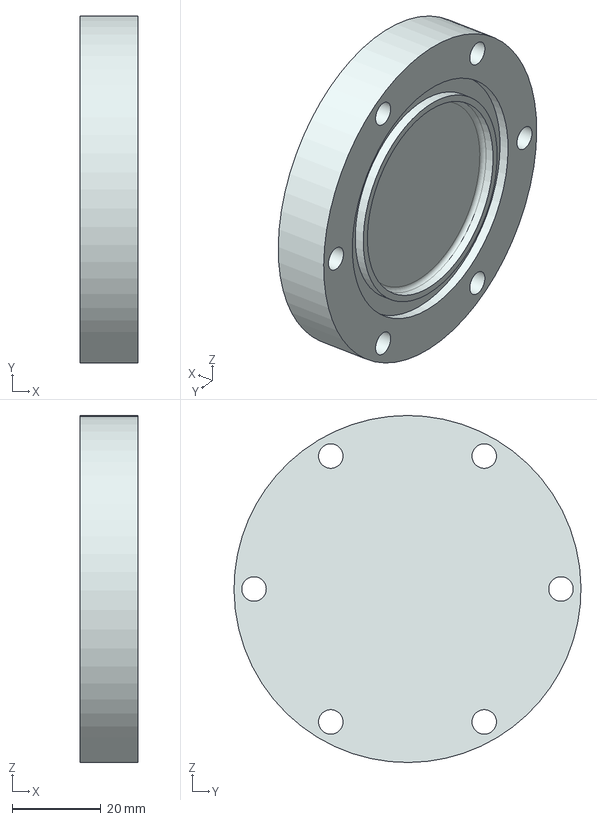
[picture p84: CAD file, 2024-02-19]
geometries/air_RVE/parts/LE-CB-008-01 Kryt.stp
13.0 x 78.0 x 78.0 mm
