janspale/DEXPAND/performance_mapping/Dexpand_Feas_Mapping.xlsx

Exp. Data |  |  |  |  |  | MM Elektra |  |  | MM ax. Turb. |  |  | MM radial cantilever |  |  | Isobutane axial impulse |  |  | Isobutane RVE |  |  | MM RVE
 | MM axial turbine | MM Elektra | MM RVE | Air RVE | Isobutane axial turbine | Size (kW) | Efficiency % | Speed | Size (kW) | Efficiency % | Speed | Size (kW) | Efficiency % | Speed | Size (kW) | Efficiency % | Speed | Size (kW) | Efficiency % | Speed | Size (kW) | Efficiency % | Speed
PR | 12 | 8.7 | 10 | 10 | 1.9 | 1 | 30.00 | 3000 | 1 | 63 | 51000 | 1 | 73 | 61000 | 1 | 68 | 54000 | 2 | 37.1 | 3000 | 1.1 | 34.6 | 3000
Efficiency | 61.95% | 36.50% | 51% | 42% | 60% | 2 | 40.00 | 3000 | 2 | 65 | 51000 | 2 | 75 | 63000 | 2 | 71 | 56000 | 3.3 | 46.5 | 3000 | 2 | 41.8 | 3000
Nominal Output (kW) | 8 | 4.1 | 8.2 | 1.2 | 20 | 4 | 40.00 | 3000 | 4 | 68 | 46000 | 4 | 75 | 45000 | 4 | 72 | 40000 | 6 | 55.9 | 3000 | 3.6 | 50.5 | 3000
Cost (k €) | 19500 | 15000 | 9000 | 5550 | 100000 | 8 | 40 | 3000 | 8 | 68 | 31000 | 8 | 75 | 32000 | 8 | 73 | 28000 | 8.2 | 60.3 | 3000 | 6.5 | 51.4 | 3000
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
