janspale/DEXPAND/experimental_data/air_PDLT/Dexpand_Elektra_Measurement_170323_130423_ps250523.xlsx

Sheet: Measurement_170323
 |  |  |  |  |  |  | 0 |  |  |  |  |  |  |  |  |  |  |  |  |  | 0
7 bar
Hz |  |  |  |  | Torque in Nm | Power Output | rpm | Inletpressure bar | Inlettemperature °C | Outletpressure bar | Volume Flow Rate Nm/h | Mass Flow Rate in kg/s | Enthalpydrop in j/kg | Efficiency | Mass flow rate (CFD) at 650 kpa at Inlet | Mass flow rate (1D) in kg/s | factorized mass flow rate (CFD) | Faktor CFD/Messung
50 |  |  |  |  | 21 | 6597.344573 | 3000 | 7.05 | 20 | 0.962 | 510 | 0.183175 | -127656.5777 | 28.21368218 | 0.17064 | 0.185735552 | 0.1850787692 | 1.010393172
6 bar
Hz |  |  |  |  | Torque in Nm | Power Output | rpm | Inletpressure bar | Inlettemperature °C | Outletpressure bar | Volume Flow Rate Nm/h | Mass Flow Rate in kg/s | Enthalpydrop in j/kg | Efficiency | Mass flow rate (CFD) at 650 kpa at Inlet | Mass flow rate (1D) in kg/s | factorized mass flow rate (CFD) | Faktor CFD/Messung
50 |  |  |  |  | 15.2 | 4775.220833 | 3000 | 6.08 | 20 | 0.9853 | 446 | 0.1601883333 | -119271.3975 | 24.99345353 | 0.17064 | 0.160028247 | 0.1596140308 | 0.996414829
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
