janspale/DEXPAND/experimental_data/MM_testrig_CTU/elektra_18052023_ORC.xlsx

Sheet: ORCdata
NOTE: | THERMAL power output - substract 2kW thermal loss at the turbine and piping; substract ballast heat in lubrication oil - 0.05*m_dot_MM, cp oil is xx |  |  |  |  | m_dot_mm is a result of balance of the condenser (thermal power output, enthalpy of the condensate)
 | "steady states" : | kW | start time | end time | =0,0042*t (°C)+2,096 | you can close the balance with heat input to the cycle (neglect pressure drops at the liquid and consider temperature after pump equal to the condensate)
 |  | 120 | 10:42:00 | 12:07:00
 |  | 100 | 13:04:00 | 14:17:00 |  | electrical efficiency of the generator:
 |  | 80 | 14:26:00 | 15:10:00 |  |  | y = 0.0057x3 - 0.0968x2 + 0.5295x + 2E-13
 |  | 60 | 16:15:00 | 17:38:00
Time Stamp | Turbine inlet temperature (°C) | Turbine inlet superheat (K) | Condensate temperature (°C) | Turbine inlet pressure (kPa abs) | Turbine outlet pressure (kPa abs) | Thermal power output (kW) | turbine rpm | Generator el. power (W) | Generator sum electricity produced (kWh) | Total heat produced (GJ)
2023-05-18 09:00 |  | -81.9 | 9.5 | 79.4
2023-05-18 09:01 |  | -81.8 | 9.4 | 79.3
2023-05-18 09:02 |  |  | 9.5 | 79.4
2023-05-18 09:03 |  |  |  | 79.3
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
