janspale/DEXPAND/experimental_data/air_PDLT/MM_axial_PDLT_compressedair_05192023.csv

timestamp | rotation speed | torque | power | volumetric flow rate (DN40) | p1 | p2 | p3 | p4 | p5 | p6 | room Temp | dew point T
hh:mm:ss | U/min | Nm | W | Nm^3/h | bar | bar | bar | bar | bar | bar | ｰC | ｰC
10:36:22 | 70.556493 | -0.023715 | -0.174994 | -0.006405 | 0.975598 | 0.973266 | 0.96889 | 0.974665 | 0.974053 | 0.974524 | 21.48782 | -47.194008
10:36:23 | 62.770289 | -0.023931 | -0.157305 | -0.023665 | 0.975711 | 0.973296 | 0.968866 | 0.974634 | 0.974 | 0.974571 | 21.503631 | -47.186762
10:36:24 | 67.384336 | -0.024892 | -0.17598 | -0.029418 | 0.975484 | 0.973305 | 0.96886 | 0.974563 | 0.974022 | 0.97456 | 21.488791 | -47.194315
10:36:26 | 70.652619 | -0.025573 | -0.189208 | -0.033494 | 0.975324 | 0.97331 | 0.968857 | 0.974513 | 0.974037 | 0.974553 | 21.478279 | -47.199664
10:36:27 | 61.424526 | -0.024708 | -0.159523 | -0.016233 | 0.975286 | 0.973318 | 0.968931 | 0.974704 | 0.973996 | 0.974406 | 21.459832 | -47.264898
10:36:28 | 54.887959 | -0.024095 | -0.138495 | -0.004007 | 0.975259 | 0.973324 | 0.968984 | 0.97484 | 0.973968 | 0.974302 | 21.446766 | -47.311104
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
