janspale/DEXPAND/experimental_data/MM_testrig_CTU/VUT_spindle/py_import_data_spindle.csv

Torque [Nm] | f [Hz] | rpm | P_avgd_VFD [W] | P_act_VFD [W] | P_yoko [W] | P_mech [W] | PF [-] | eta_el_VFD [-] | eta_el_yoko [-] | slip [-] | delta_yoko [W] | delta_yoko [-]
1 | 200 | 5986 | 1125.4 | 1151.6 | 1219.783333 | 0.14 | 626.8123333 | 0.556968485 | 0.513871862 | 0.002333333 | 94.38333333 | 0.07737713
1 | 266.6 | 7982 | 1442.266667 | 1443.533333 | 1547.661017 | 0.153050847 | 836.8081695 | 0.580203501 | 0.540692154 | 0.0020005 | 105.3943503 | 0.068099118
1 | 333.33 | 9984.705882 | 1834.666667 | 1819.6 | 1842.759615 | 0.163807692 | 1045.60225 | 0.569914017 | 0.567411094 | 0.001519427 | 8.092948718 | 0.004391755
1 | 400 | 11984.26415 | 2320.066667 | 2297.833333 | 2119.709302 | 0.174 | 1254.568384 | 0.540746696 | 0.591858696 | 0.001311321 | -200.3573643 | -0.094521152
1 | 466.66 | 13978.17647 | 2294.8 | 2297.833333 | 2284.5 | 0.244 | 1463.6751 | 0.637822512 | 0.640698227 | 0.00154456 | -10.3 | -0.004508645
1 | 533.333 | 15972.07353 | 2499.2 | 2520.966667 | 2513.463415 | 0.313731707 | 1672.348805 | 0.669153651 | 0.665356335 | 0.001744781 | 14.26341463 | 0.005674805
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
