janspale/DEXPAND/experimental_data/MM_testrig_CTU/W50_Spratech/p_ad_vs_time.png

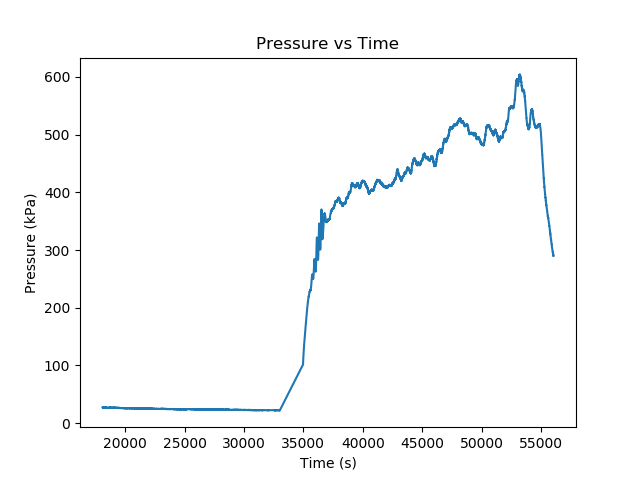
experimental_data/MM_testrig_CTU/W50_Spratech/p_ad_vs_time.png
