janspale/DEXPAND/experimental_data/MM_testrig_CTU/W50_Spratech/P_shaft_vs_n_shaft.png

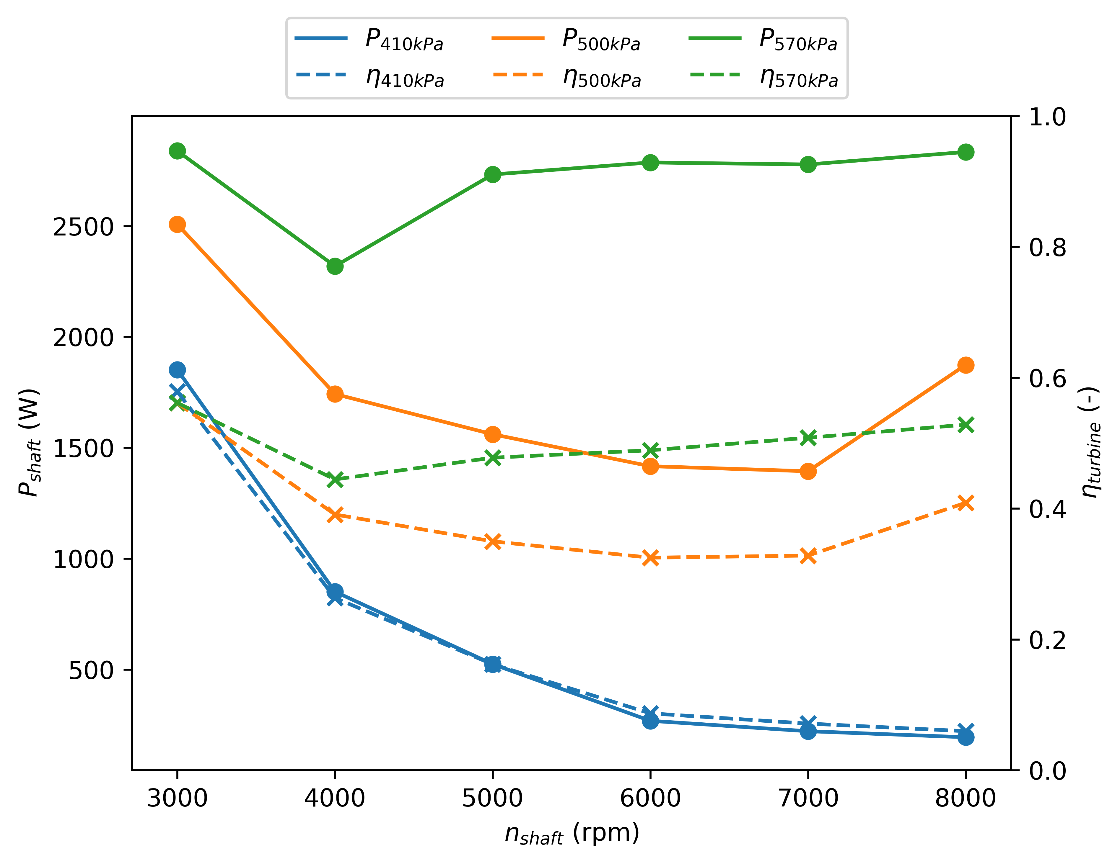
experimental_data/MM_testrig_CTU/W50_Spratech/P_shaft_vs_n_shaft.png
