janspale/DEXPAND/performance_mapping/figs/sensitivity_analysis_alpha_stator.png

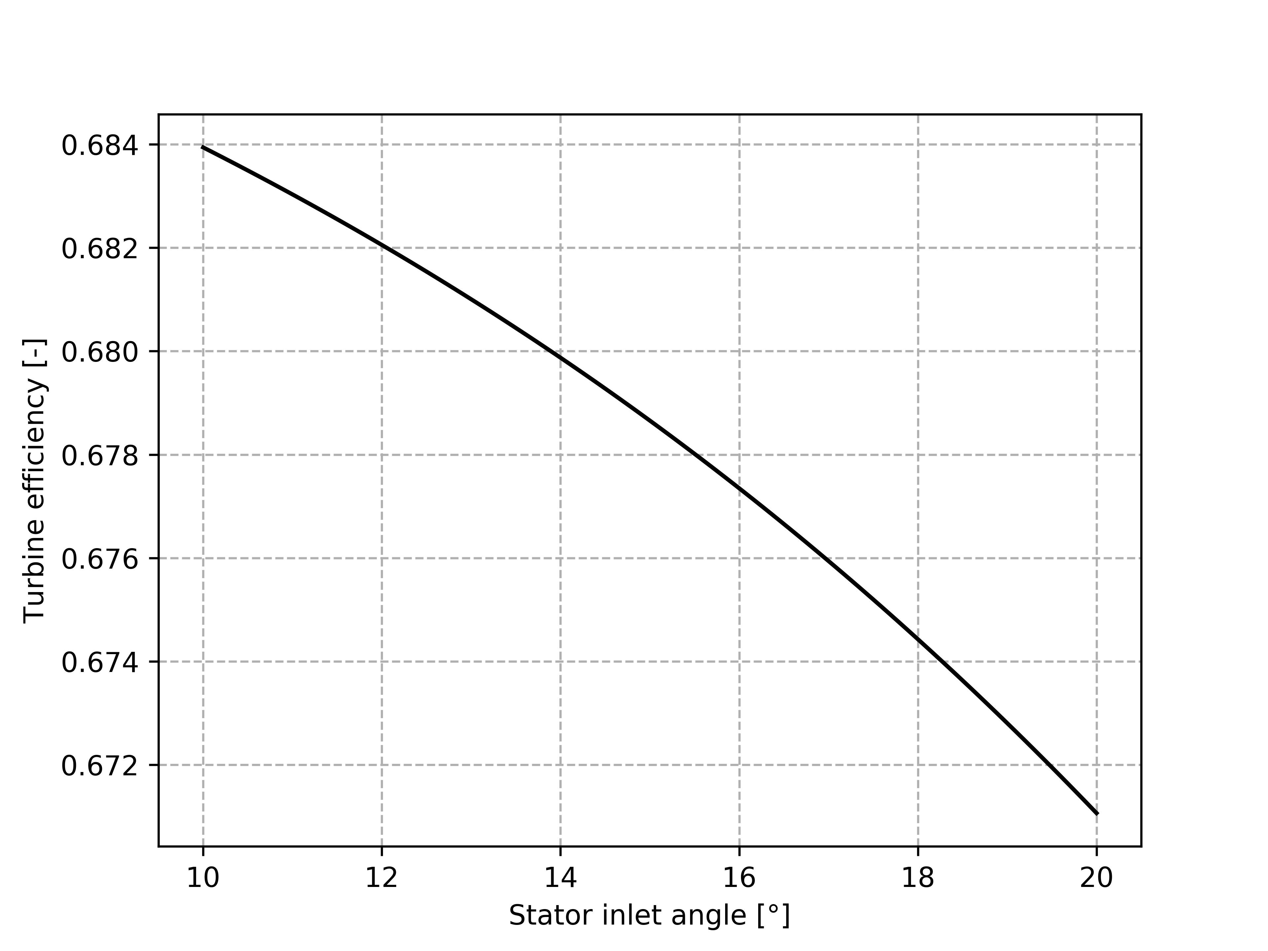
performance_mapping/figs/sensitivity_analysis_alpha_stator.png
