janspale/DEXPAND/performance_mapping/figs/sensitivity_analysis_D_mid.png

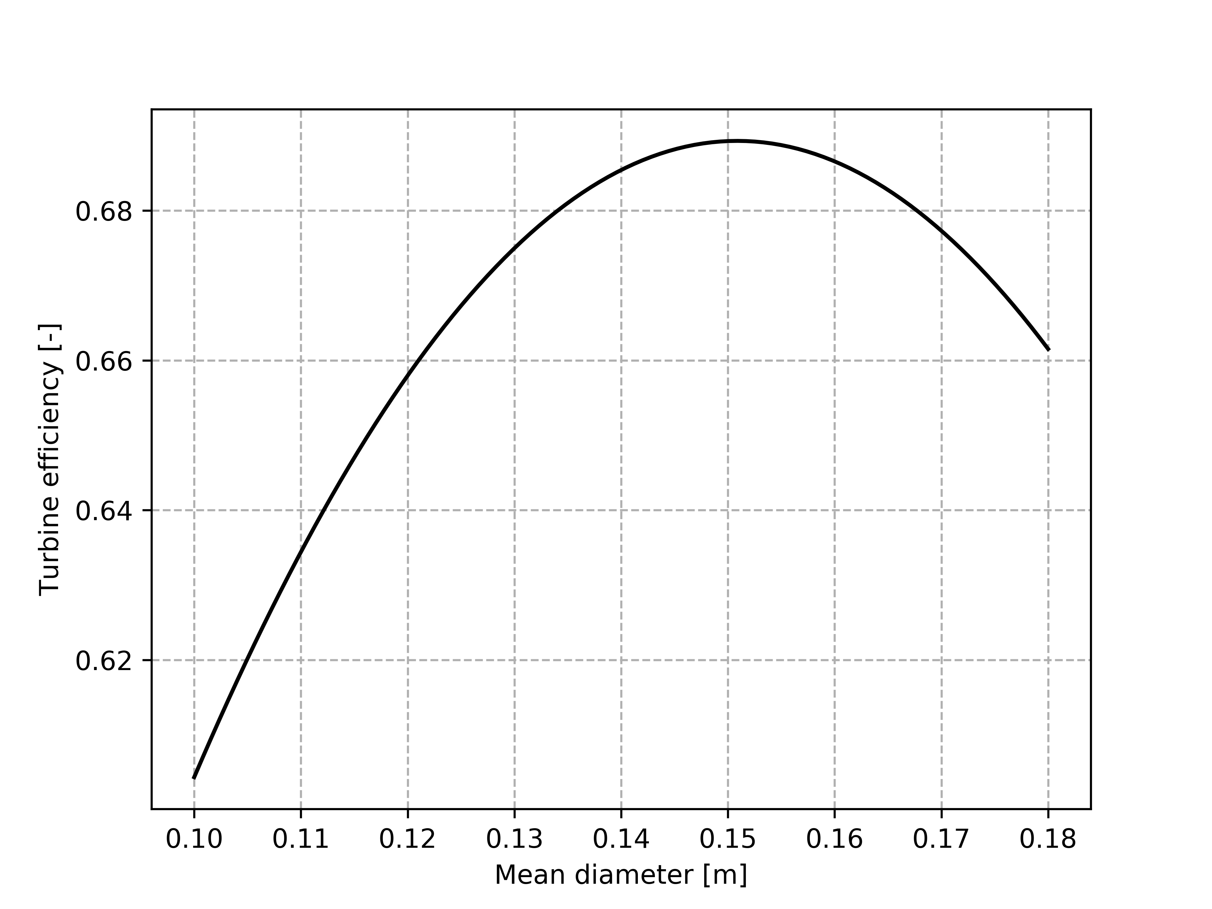
performance_mapping/figs/sensitivity_analysis_D_mid.png
