janspale/DEXPAND/performance_mapping/figs/sensitivity_analysis_rpm.png

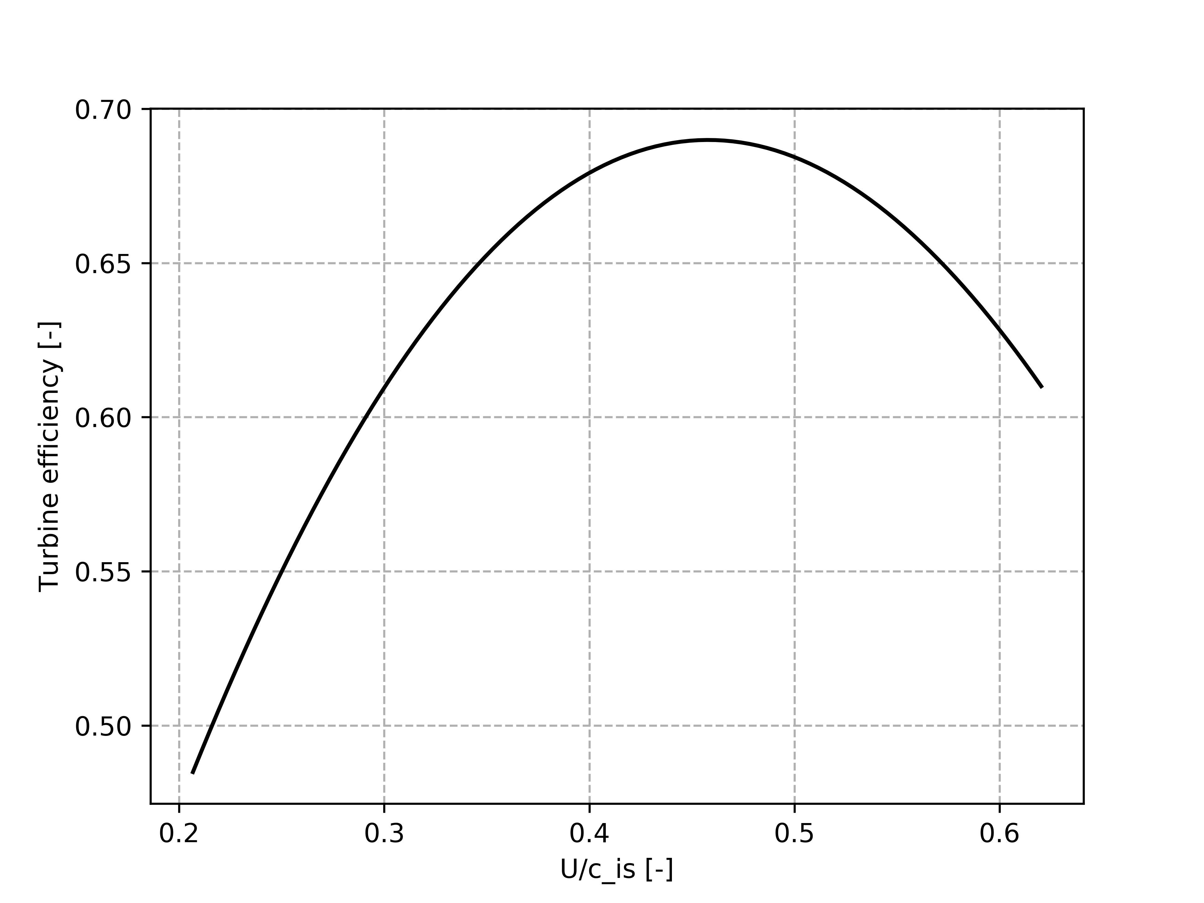
performance_mapping/figs/sensitivity_analysis_rpm.png
