janspale/DEXPAND/(commit log)

2024-02-19 new file: experimental_data/air_PDLT/ MM_axial_PDLT_compressedair_05192023.csv
    [MM_axial_PDLT_compressedair_05192023.csv]
2024-02-19 RVE airtests - design conditions, elm brake
    [RVE_air_PDLT_steady_states_designconditions.csv]
2024-02-19 /AxT2 Expander Assembly V2.3.stl
2024-02-19 new file: AxT2-R-02 RotorBuckets_v2.stl new file: AxT2-S-02 StatorNozzles_v2.stl
    [AxT2-R-02 RotorBuckets_v2.stl, AxT2-S-02 StatorNozzles_v2.stl]
2024-02-19 new files - RVE parts
    [LE-CB-001-01 Stator.stp, LE-CB-002-01 Rotor.stp, LE-CB-003-01 Čelo.stp, LE-CB-005-01 Sběrnice emisní.stp, LE-CB-006-01 Kroužek zajišťovací.stp, LE-CB-007-01 Lamela.stp, LE-CB-008-01 Kryt.stp, LE-CB-009-01 Podložka.stp]
2024-02-19 new file: Elektra_100622.stl new file: Elektra_100622.stp new file: LAUFRAD_ASM.stl
2024-02-21 added & deleted files
    [Dexpand_Elektra_Measurement_170323_130423_ps250523.xlsx]
2024-02-27 new file: design_tools/RVE_small_Scale.xlsm new file: design_tools/orcturbax_v8_r10.xlsm
    [RVE_small_Scale.xlsm, orcturbax_v8_r10.xlsm]
2024-03-01 new file: design_tools/orc_axial/__pycache__/ new file: design_tools/orc_axial/axial_meanline_design.py new file: design_tools/orc_axial/units.py
    [orcturbax_v8_r10.xlsm]
2024-04-02 deleted: experimental_data/MM_testrig_CTU/P_shaft_vs_n_shaft.png
    [evaluated_data_2202324.csv]
2024-04-10 modified: experimental_data/MM_testrig_CTU/W50_Spratech/P_shaft_vs_n_shaft.png modified: experimental_data/MM_testrig_CTU/W50_Spratech/evaluated_data_2202324.csv modified: experimental_data/MM_testri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
    [evaluated_data_2202324.csv]
2024-06-21 modified: README.md renamed: Gamma_P_v_diagram.png -> design_tools/orc_axial/Gamma_P_v_diagram.png renamed: Gamma_T_s_diagram.png -> design_tools/orc_axial/Gamma_T_s_diagram.png renamed: expansion_li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
    [Dexpand_Design_study_apw100624.xlsx, Dexpand_Feas_Mapping.xlsx, evaluated_data_2202324.csv]
2024-08-23 modified: README.md modified: design_tools/orc_axial/axial_meanline_design.py new file: design_tools/orc_axial/sankey.py new file: design_tools/orc_axial/thermal_loss.py new file: expansion_line_h_s.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
2024-09-09 Rename energies-17-01185.pdf to Concept and Design of a Velocity Compounded Radial Four-Fold ReEntry Turbine for Organic Rankine Cycle (ORC) Applications
2024-09-09 Add files via upload
    JSC - Concept and Design of a Velocity Compounded Radial Four-Fold ReEntry Turbine for Organic Rankine Cycle (ORC) Applications - by Streit et al.
2024-10-28 modified: design_tools/orc_axial/axial_meanline_design.py new file: experimental_data/MM_testrig_CTU/VUT_spindle/eta_el_VFD_heatmap.png new file: experimental_data/MM_testrig_CTU/VUT_spindle/eta_eval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
    [py_import_data_spindle.csv]
